MDNich/MIT_Rkt_Aurora_Aero/README.md

# Aurora Aerodynamics Subteam

In this repository, one can find CFD analyses, solidworks files, and other essential infrastructure for the Aerodynamic aspects of the Aurora Project.

(c) MIT Rocket Team 2024
