MDNich/MIT_Rkt_Aurora_Aero/AeroShell_proj/New/ANSYS_wd/Report.htm

ANSYS Logo

Date

2024/10/16 18:46:21

# Contents

1. File Report
Table 1 File Information for FFF
2. Mesh Report
Table 2 Mesh Information for FFF
3. Physics Report
Table 3 Domain Physics for FFF
Table 4 Boundary Physics for FFF
4. User Data

# 1. File Report

Table 1. File Information for FFF

Case | FFF
File Path | \\Mac\Home\Downloads\new_files\dp0\FFF\Fluent\FFF.flprj
File Date | 16 október 2024
File Time | 06:39:04 du.
File Type | CFF
File Version | --

# 2. Mesh Report

Table 2. Mesh Information for FFF

Domain | Nodes | Elements
solide | 101767 | 532187

# 3. Physics Report

Table 3. Domain Physics for FFF

Domain - solide
Type | FLUID
Location | solide

Table 4. Boundary Physics for FFF

Domain | Boundaries
solide | Boundary - backwind
| Type | PRESSURE-OUTLET
| Location | backwind
| Boundary - forwardwind
| Type | VELOCITY-INLET
| Location | forwardwind
| Boundary - sidel
| Type | PRESSURE-OUTLET
| Location | sidel
| Boundary - sider
| Type | PRESSURE-OUTLET
| Location | sider
| Boundary - top
| Type | PRESSURE-OUTLET
| Location | top
| Boundary - wall solide
| Type | WALL
| Location | wall-solide

# 4. User Data
