MDNich/MIT_Rkt_Aurora_Aero/AeroShell_proj/New/ANSYS_wd/Report/index.html

Image file not found

# Ansys Fluent Simulation Report

Analyst | mdn
Date | 10/23/2024 11:12 AM

### Table of Contents

## System Information

Application | Fluent
Settings | 3d, pressure-based, SST k-omega
Version | 24.2.0-10192
Source Revision | 149ed7492d
Build Time | May 13 2024 11:26:32 EST
CPU | UNKNOWN
OS | Windows

## Geometry and Mesh

## Mesh Size

Cells | Faces | Nodes
418755 | 854773 | 78719

## Mesh Quality

Name | Type | Min Orthogonal Quality | Max Aspect Ratio
aeroshell1.0_ansys_thiswillwork | Tet Cell | 0.20434347 | 13.010097

## Orthogonal Quality

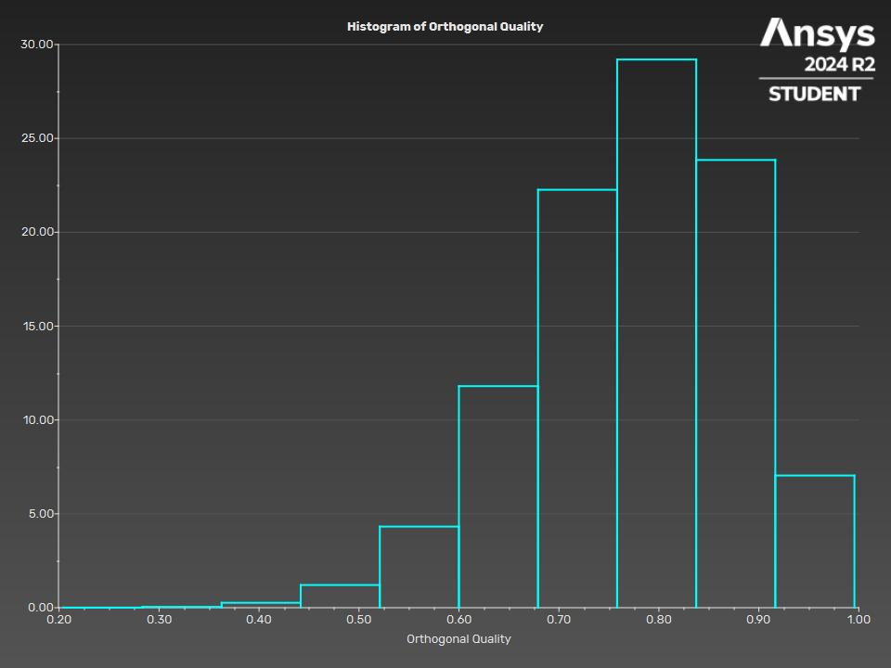
[picture p2: AeroShell_proj/New/ANSYS_wd/Report/media/4b58dbcf-9151-11ef-aaf2-bc9a78563412_image.png]
Image file not found


## Simulation Setup

## Physics

## Models

Model | Settings
Space | 3D
Time | Steady
Viscous | SST k-omega turbulence model

## Material Properties

Fluid
air
Density | 1.225 kg/m^3
Cp (Specific Heat) | 1006.43 J/(kg K)
Thermal Conductivity | 0.0242 W/(m K)
Viscosity | 1.7894e-05 kg/(m s)
Molecular Weight | 28.966 kg/kmol
Solid
aluminum
Density | 2719 kg/m^3
Cp (Specific Heat) | 871 J/(kg K)
Thermal Conductivity | 202.4 W/(m K)

## Cell Zone Conditions

Fluid
aeroshell1.0_ansys_thiswillwork
Material Name | air
Specify source terms? | no
Specify fixed values? | no
Frame Motion? | no
Laminar zone? | no
Porous zone? | no
3D Fan Zone? | no

## Boundary Conditions

Inlet
fata
Velocity Specification Method | Magnitude, Normal to Boundary
Reference Frame | Absolute
Velocity Magnitude [m/s] | 343
Supersonic/Initial Gauge Pressure [Pa] | 0
Turbulence Specification Method | Intensity and Viscosity Ratio
Turbulent Intensity [%] | 2
Turbulent Viscosity Ratio | 10
Outlet
out
Backflow Reference Frame | Absolute
Gauge Pressure [Pa] | 0
Pressure Profile Multiplier | 1
Backflow Direction Specification Method | Normal to Boundary
Turbulence Specification Method | Intensity and Viscosity Ratio
Backflow Turbulent Intensity [%] | 5
Backflow Turbulent Viscosity Ratio | 10
Backflow Pressure Specification | Total Pressure
Build artificial walls to prevent reverse flow? | no
Radial Equilibrium Pressure Distribution | no
Average Pressure Specification? | no
Specify targeted mass flow rate | no
Wall
wall-aeroshell1.0_ansys_thiswillwork
Wall Motion | Stationary Wall
Shear Boundary Condition | No Slip
Wall Surface Roughness | Standard
Wall Roughness Height [m] | 0
Wall Roughness Constant | 0.5

## Reference Values

Area | 1 m^2
Density | 1.225 kg/m^3
Enthalpy | 0 J/kg
Length | 1 m
Pressure | 0 Pa
Temperature | 288.16 K
Velocity | 1 m/s
Viscosity | 1.7894e-05 kg/(m s)
Ratio of Specific Heats | 1.4
Yplus for Heat Tran. Coef. | 300
Reference Zone | aeroshell1.0_ansys_thiswillwork

## Solver Settings

Equations
Flow | True
Turbulence | True
Numerics
Absolute Velocity Formulation | True
Pseudo Time Explicit Relaxation Factors
Density | 1
Body Forces | 1
Turbulent Kinetic Energy | 0.75
Specific Dissipation Rate | 0.75
Turbulent Viscosity | 1
Explicit Momentum | 0.5
Explicit Pressure | 0.5
Pressure-Velocity Coupling
Type | Coupled
Pseudo Time Method (Global Time Step) | True
Discretization Scheme
Pressure | Second Order
Momentum | Second Order Upwind
Turbulent Kinetic Energy | Second Order Upwind
Specific Dissipation Rate | Second Order Upwind
Solution Limits
Minimum Absolute Pressure [Pa] | 1
Maximum Absolute Pressure [Pa] | 5e+10
Minimum Static Temperature [K] | 1
Maximum Static Temperature [K] | 5000
Minimum Turb. Kinetic Energy [m^2/s^2] | 1e-14
Minimum Spec. Dissipation Rate [s^-1] | 1e-20
Maximum Turb. Viscosity Ratio | 100000

## Run Information

Number of Machines | 1
Number of Cores | 4
Case Read | 21.134 seconds
Data Read | 0.727 seconds
Iteration | 78.413 seconds
AMG | 36.519 seconds
Virtual Current Memory | 6.64544 GB
Virtual Peak Memory | 6.68229 GB
Memory Per M Cell | 12.1125

## Solution Status

#### Iterations: 100

| Value | Absolute Criteria | Convergence Status
continuity | 0.09712484 | 0.001 | Not Converged
x-velocity | 0.0003147829 | 0.001 | Converged
y-velocity | 0.0001747776 | 0.001 | Converged
z-velocity | 0.000171075 | 0.001 | Converged
k | 0.01620988 | 0.001 | Not Converged
omega | 0.01409847 | 0.001 | Not Converged

## Plots

- Residuals

## Residuals

## Contours

- shearst
- totp
- dynp
- statp

## shearst

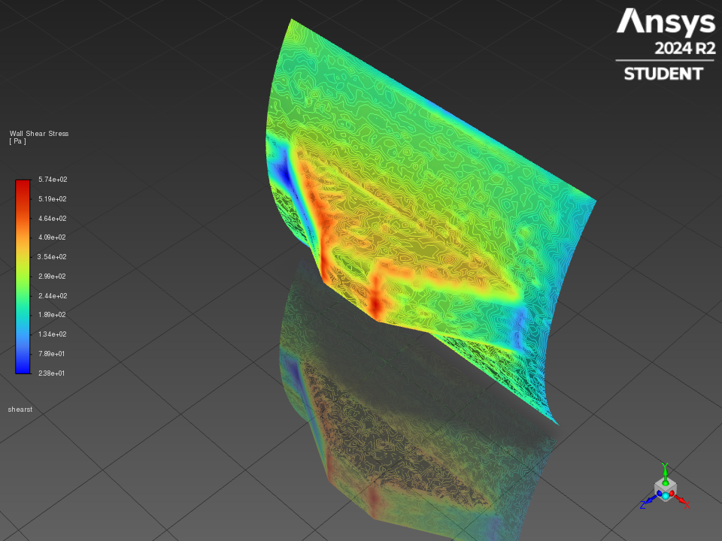
[picture p3: AeroShell_proj/New/ANSYS_wd/Report/media/4d85e509-9151-11ef-a574-bc9a78563412_image.png]
Image file not found


## totp

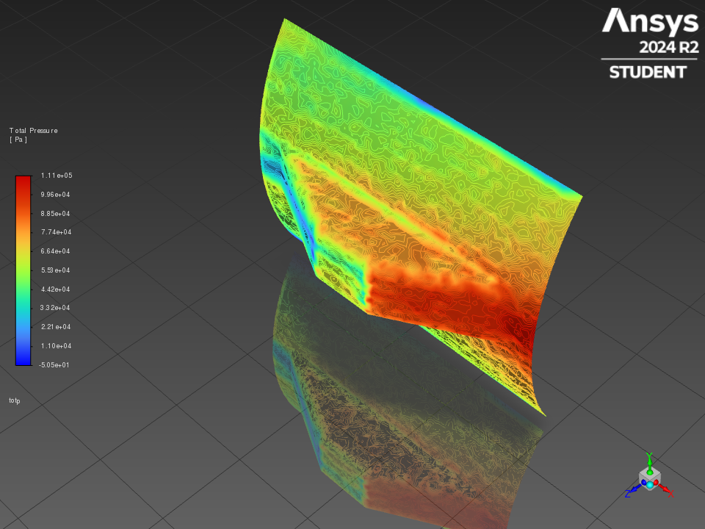
[picture p4: AeroShell_proj/New/ANSYS_wd/Report/media/4f966771-9151-11ef-b3bf-bc9a78563412_image.png]
Image file not found


## dynp

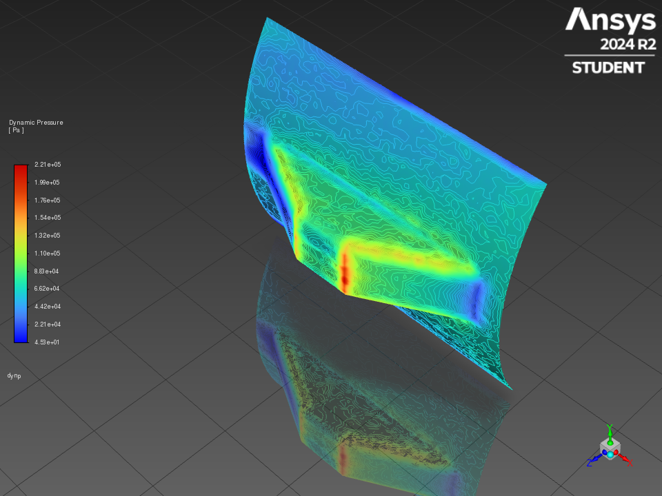
[picture p5: AeroShell_proj/New/ANSYS_wd/Report/media/515c199f-9151-11ef-837b-bc9a78563412_image.png]
Image file not found


## statp

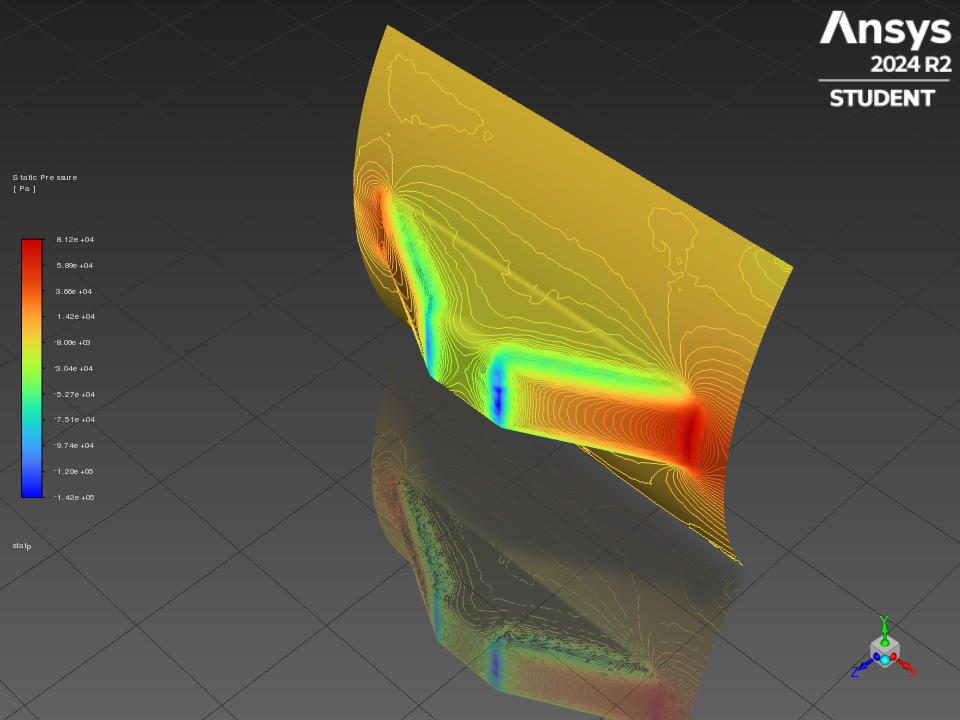
[picture p6: AeroShell_proj/New/ANSYS_wd/Report/media/534bf1fb-9151-11ef-a4d0-bc9a78563412_image.png]
Image file not found


## Pathlines

- pathlines-1

## pathlines-1

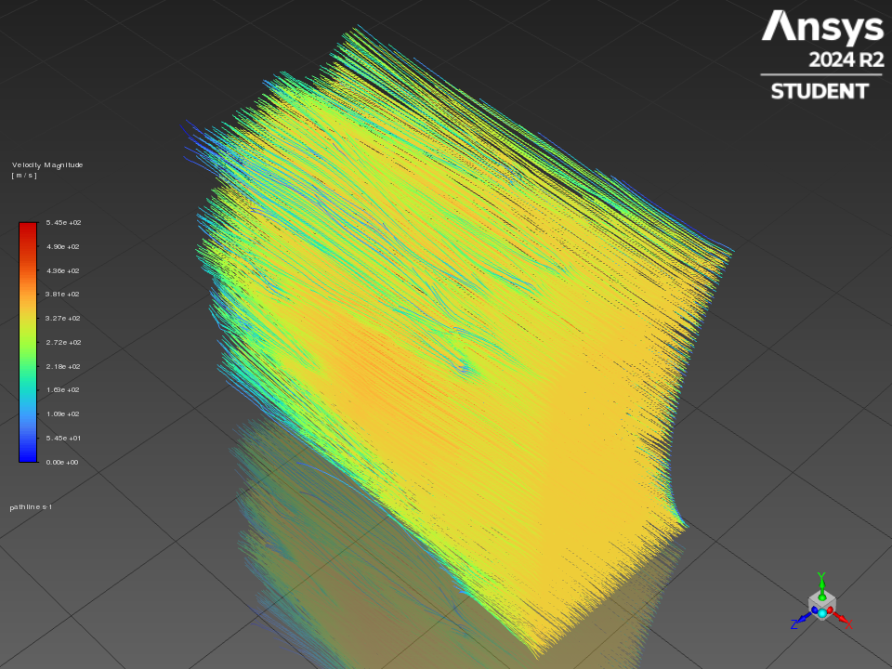
[picture p7: AeroShell_proj/New/ANSYS_wd/Report/media/572a354f-9151-11ef-ac23-bc9a78563412_image.png]
Image file not found


## User Data

- image-1

## image-1

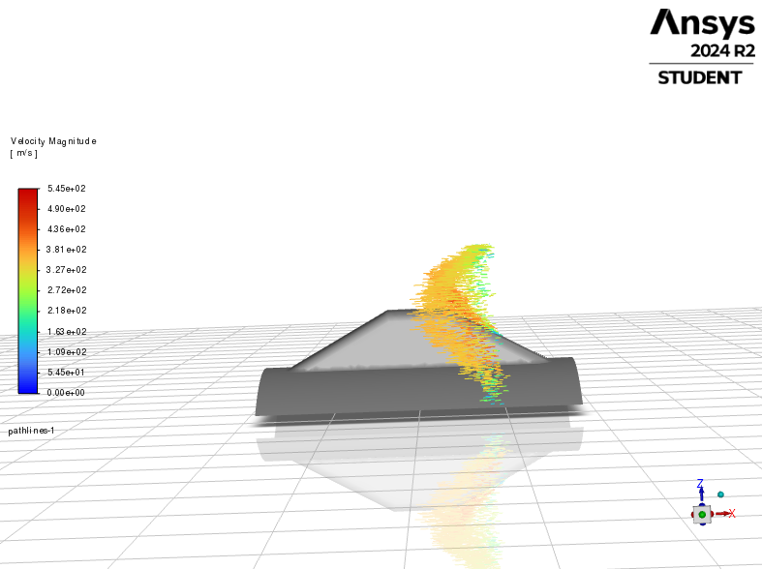
[picture p8: AeroShell_proj/New/ANSYS_wd/Report/media/58689a4f-9151-11ef-af96-bc9a78563412_image.png]
Image file not found
