MDNich/MIT_Rkt_Aurora_Aero/CureChamber/Epoxy Heat Curing Notes.pdf

Epoxy Heat Curing Research:

Options:
1. Heat oven
2. Custom enclosure
3. Heat lamp/blankets
4. Furnace

Potential issues:
- Too big to fit in heat oven/furnace
- Can’t reach required temperature
- Manufacturing of enclosure too difficult
- Space??
- Money

Most viable option atm: Custom enclosure/ heat lamp combo

Sources for reference:
- UV Curing Enclosure Example (https://forum.formlabs.com/t/custom-diy-large-size-uv-curing-enclosure-wip/7543) - Basic design of enclosure is transferable to our custom enclosure; heat lamp type will need to be modified to a much more powerful model for our use and inner layers may require more insulation to in turn be equipped to handle higher temperatures
- Cure Box For Composite Builds (https://www.youtube.com/watch?v=HxJONzVlXNQ) - Only currently utilizes on lamp, proportions need to be scaled up for our use and to include heat lamps on four faces to perform consistent curing

Concept Sketch:

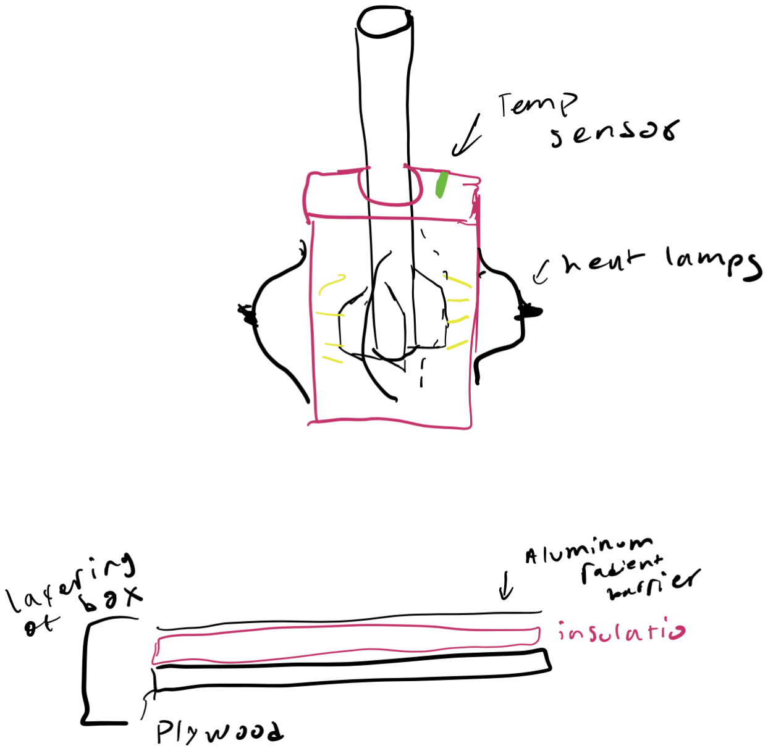
[picture p10: figure]

Type of epoxy: System 40600 Spec Sheet (https://s3.amazonaws.com/cdn.fibreglast.com/downloads/04160.pdf)

Curing Temperatures and Times:

Ideal Time and Temp:

### To Build Oven

Parts Needed:
1. Insulation board (https://www.lowes.com/pd/Insulfoam-Common-0-5-in-x-4-ft-x-8-ft-Actual-0-5-in-x-4-ft-x-8-ft-1-R-1-9-Faced-Polystyrene-Garage-Door-Foam-Board-Insulation/3033278)
a. 2 layers?
2. Insulation Aluminum Tape (https://www.uline.com/Product/Detail/S-18880/3M-Foil-Tape/3M-3311-Aluminum-Foil-Tape-2-x-50-yds?id=S-18880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)
3. Regular insulation (https://www.homedepot.com/p/ROCKWOOL-Safe-n-Sound-3-in-x-15-1-4-in-x-47-in-Soundproofing-and-Fire-Resistant-Stone-Wool-Insulation-Batt-59-7-sq-ft-RXSS31525/20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)
4. Plywood (https://www.homedepot.com/p/Blue-Ribbon-Oriented-Strand-Board-Common-19-32-in-x-4-ft-x-8-ft-Actual-0-578-in-x-47-75-in-x-95-75-in-691459/205821485)
5. 2x4s (https://www.homedepot.com/p/2-in-x-4-in-x-96-in-2-Premium-Grade-KD-HT-Stud-058449/312528776)
6. Silver heat reflective foil (https://www.homedepot.com/p/Pro-Space-48-in-x-10-ft-Radiant-Barrier-Bubble-Aluminum-Foil-Reflective-Insulation-RBQP54810/327522328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)
7. Fans for circulation (https://www.mcmaster.com/products/fans/fans-1~/high-temperature-equipment-cooling-fans/)
8. PID controller? (https://www.amazon.com/CGELE-Temperature-Controller-180-240V-Thermocouple/dp/B08ZYHFBYW?hvadid=697547374301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)
9. Heat Lamp Controller (https://www.amazon.com/REPTIZOO-Thermostat-Temperature-Controller-Function/dp/B0BGS517FT?th=1&psc=1) x2
a. Bulb (https://www.amazon.com/SPOTTEDSALAMADER-Infrared-Basking-Reptile-Heating/dp/B0DCB7GGYH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)
b. Mounts (https://www.amazon.com/2RZ-Reptile-Ceramic-Bracket-Included/dp/B07YWPPLMH?sp_csd=d2lkZ2V0TmFtZT1zcF9hdGY) x2
Cost of Parts (assuming RT does not have anything)
Part | Amount | Cost per Unit | Total Cost
PID Controller (https://www.amazon.com/Temperature-Controller-Jaybva-Programmable-Thermocouple/dp/B07XKRQ1SY) | 1 | 37 | 37
Heat Lamp (https://www.homedepot.com/p/Feit-Electric-250-Watt-BR40-Red-Reflector-E26-Heat-Lamp-Dimmable-120-Volt-Incandescent-Light-Bulb-250R40-10/304312180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) | 2 | 6 | 12
Lamp holder (https://www.amazon.com/AdiyZ-Pendant-Light-Cord-Chandelier/dp/B0C69JPY5S) | 2 | 17 | 34
Aluminum Foil Tape (https://www.amazon.com/Aluminum-Ductwork-Temperature-Insulation-Adhesive/dp/B0B6NDFXPN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) | 1 | 6 | 6
Insulation (https://www.homedepot.com/p/Owens-Corning-R13-Thermafiber-Fire-and-Sound-Guard-Plus-Mineral-Wool-Insulation-Batt-15-in-x-47-in-1196588/319880476) | 1 | 50 | 50

Aluminum Foil Wrap (https://www.homedepot.com/p/Pro-Space-48-in-x-10-ft-Radiant-Barrier-Bubble-Aluminum-Foil-Reflective-Insulation-RBQP54810/327522328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) | 1 | 24 | 24
Carbon Steel Plate (https://www.onlinemetals.com/en/buy/carbon-steel/18-ga-0-048-carbon-steel-sheet-a1008-cold-roll/pid/14695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) | 6 | 18.47 | 111
Total | | | 274

Insulation Board Specs: (https://pdf.lowes.com/productdocuments/a7ee0c58-6976-4418-82a2-40a9ee2816f8/62997833.pdf)

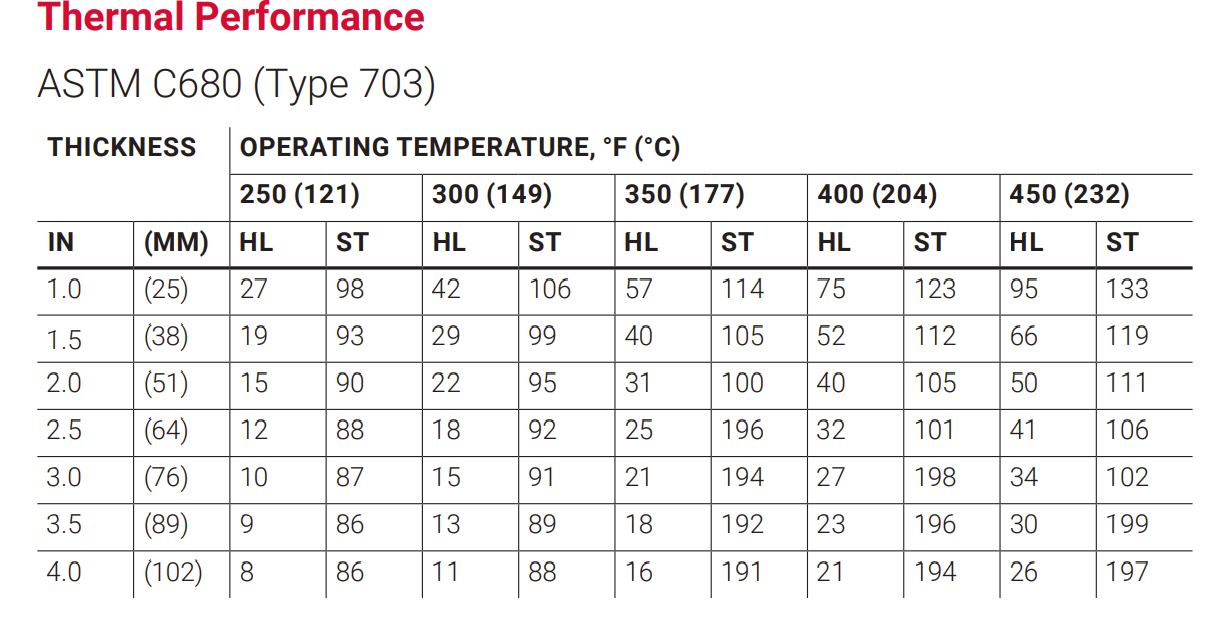
[picture p11: figure]

Insulation Option (https://www.homedepot.com/p/Owens-Corning-15-in-x-47-in-R21-Thermafiber-Fire-and-Sound-Guard-Plus-Mineral-Wool-Insulation-Batt-1196589/319880604)
