MDNich/MIT_Rkt_Aurora_Aero/FEA_docs/rosette.pdf

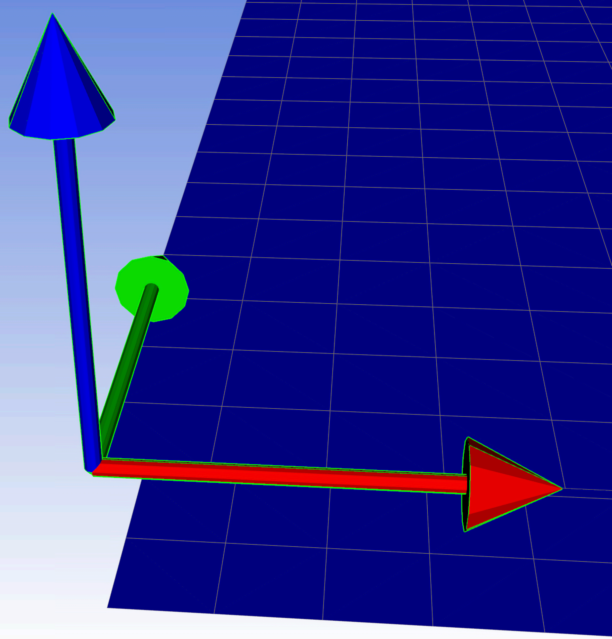
[picture p20: page 1]
