MDNich/MIT_Rkt_Aurora_Aero/FEA_docs/dessin1.pdf

11.714

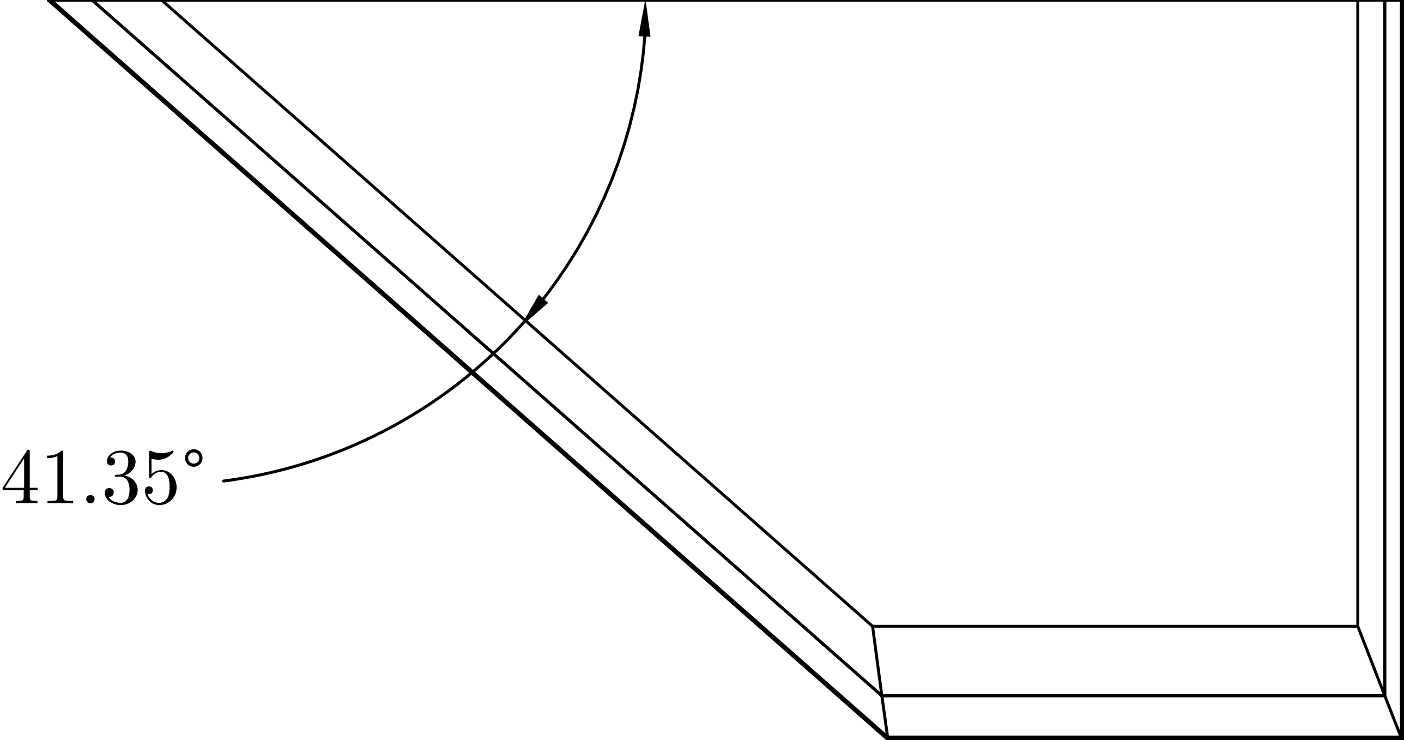
[picture p21: figure]

6

3

8

6

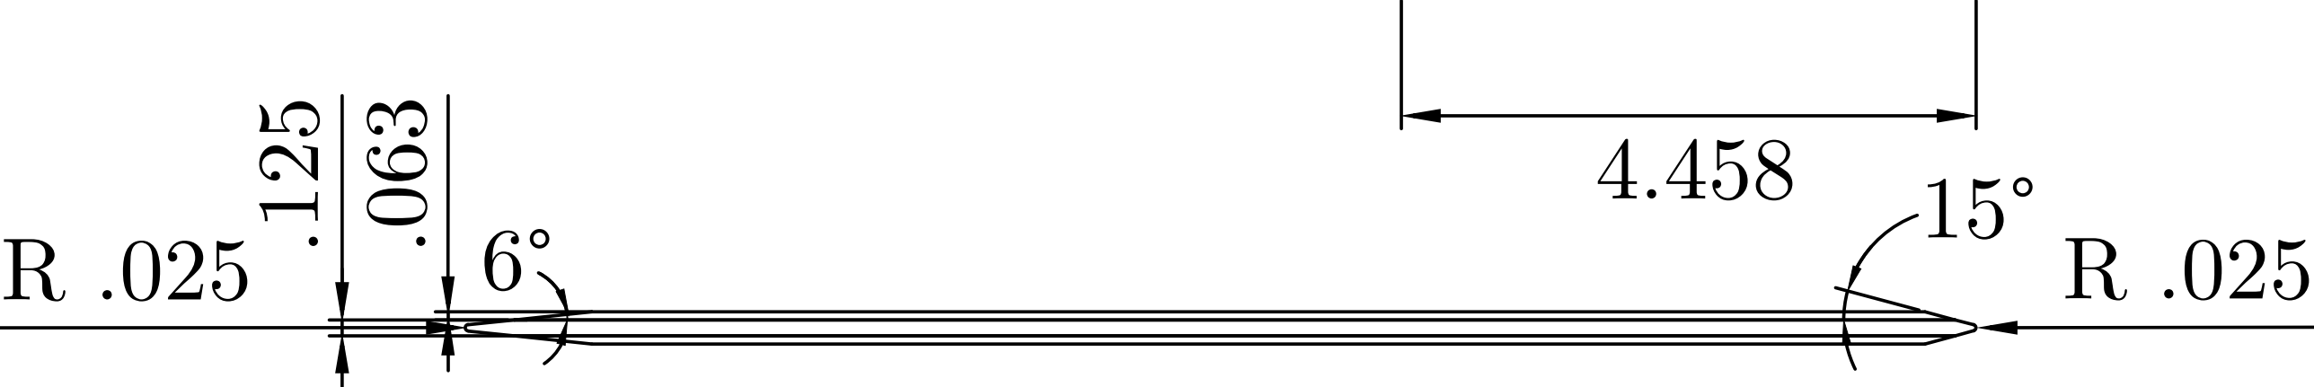
[picture p22: figure]
