MDNich/MIT_Rkt_Aurora_Aero/FEA_docs/rtlogo.pdf

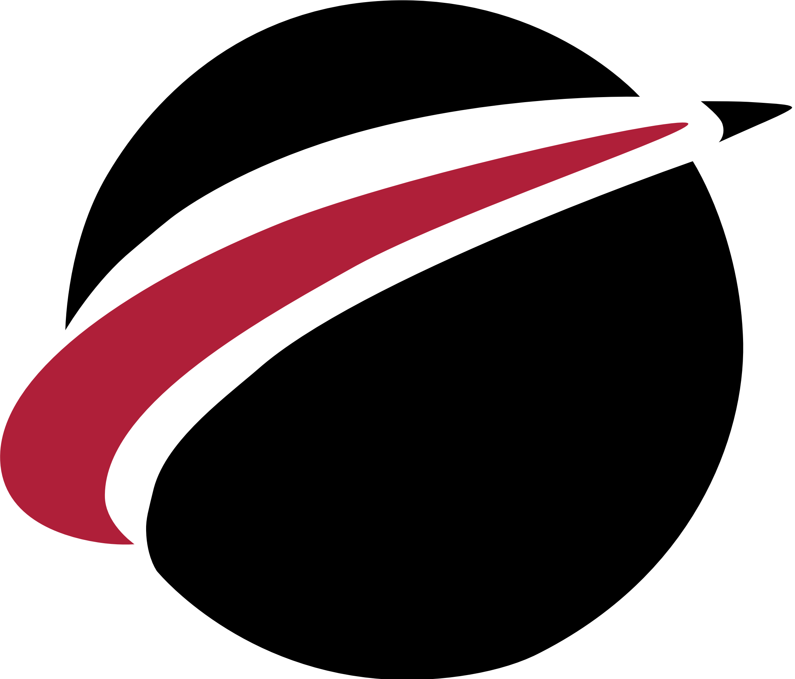
[picture p23: figure]

MIT
TEAM

ROCKET
