MDNich/MIT_Rkt_Aurora_Aero/AeroShell_proj/Analysis/img/sldwrks/new_Mach1_res.png

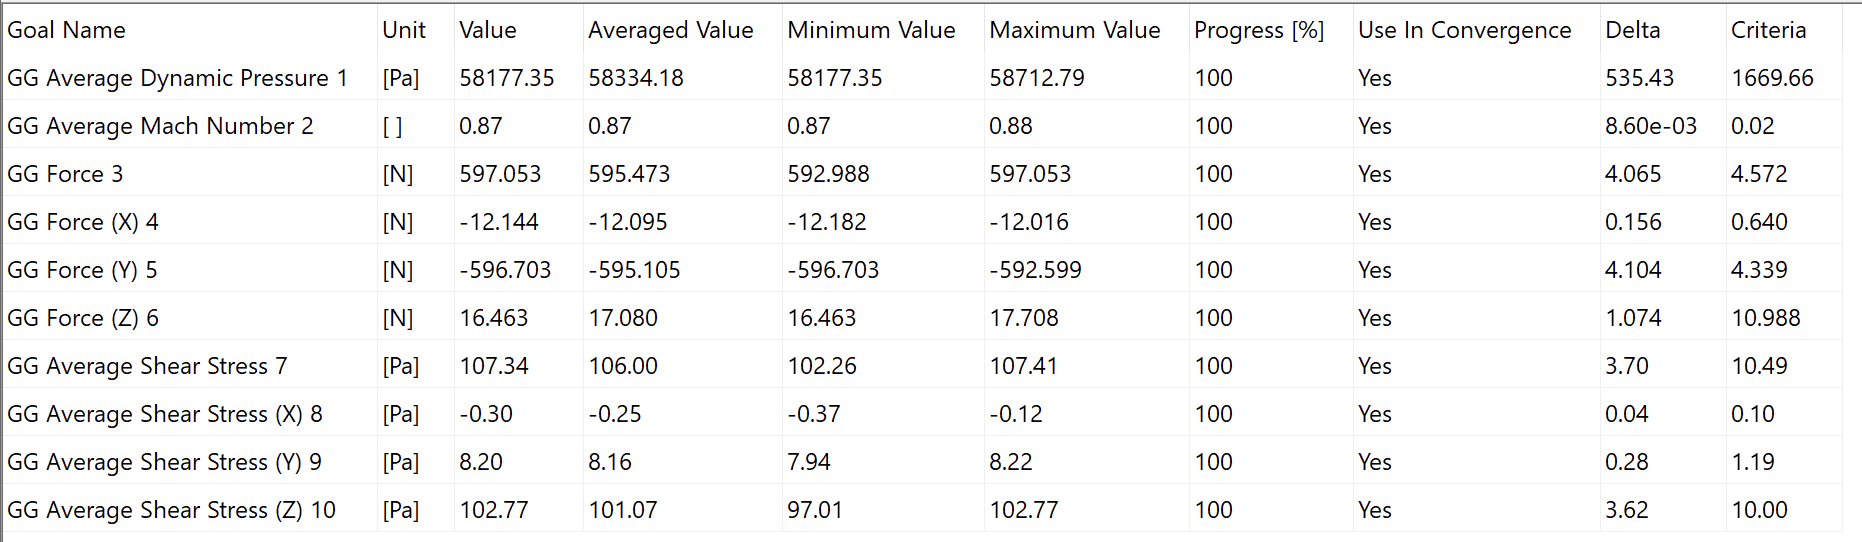
AeroShell_proj/Analysis/img/sldwrks/new_Mach1_res.png
