MDNich/MIT_Rkt_Aurora_Aero/AeroShell_proj/Analysis/src/ansys/new/staticPressure.png

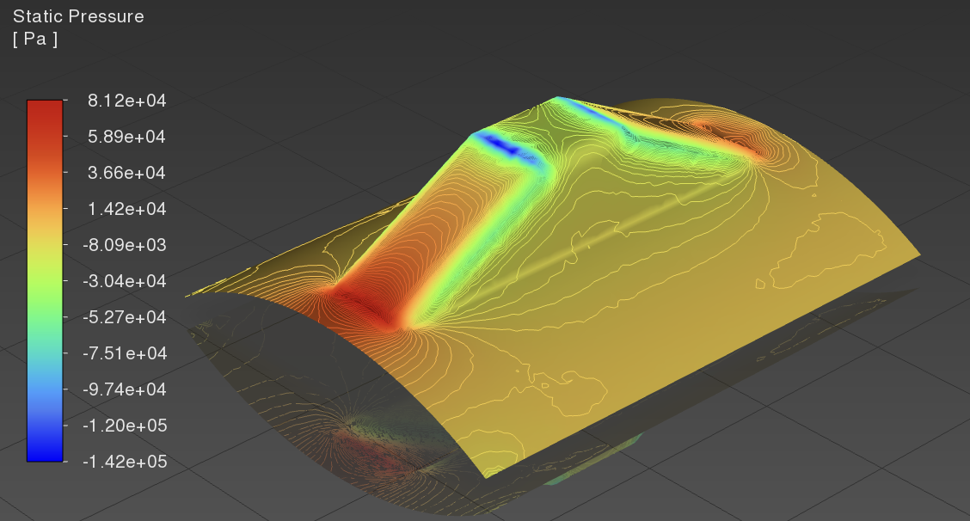
AeroShell_proj/Analysis/src/ansys/new/staticPressure.png
