MDNich/MIT_Rkt_Aurora_Aero/AeroShell_proj/Analysis/src/ansys/new/totalPressure.png

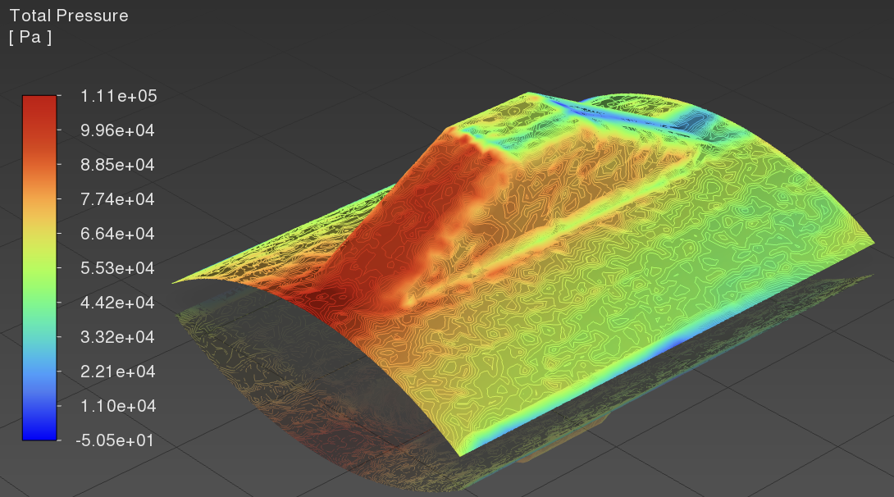
AeroShell_proj/Analysis/src/ansys/new/totalPressure.png
