MDNich/MIT_Rkt_Aurora_Aero/AeroShell_proj/New/ANSYS_wd/Report/media/nexus_front_page.png

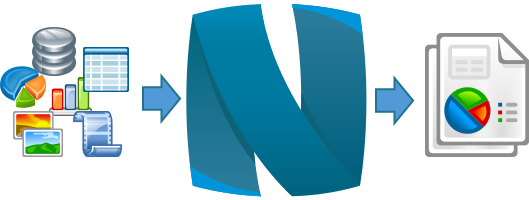
AeroShell_proj/New/ANSYS_wd/Report/media/nexus_front_page.png
