MDNich/MIT_Rkt_Aurora_Aero/AeroShell_proj/New/preview_new.png

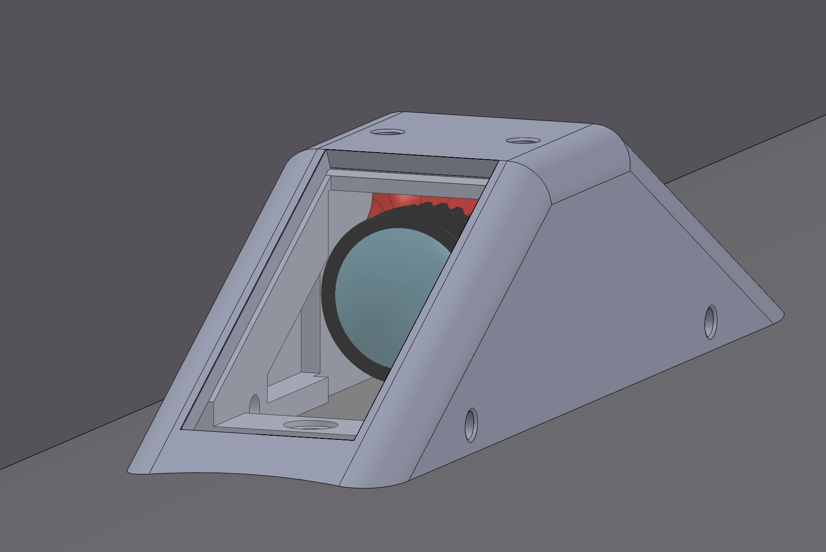
AeroShell_proj/New/preview_new.png
