MDNich/MIT_Rkt_Aurora_Aero/CureChamber/cureChamberCircuitry.png

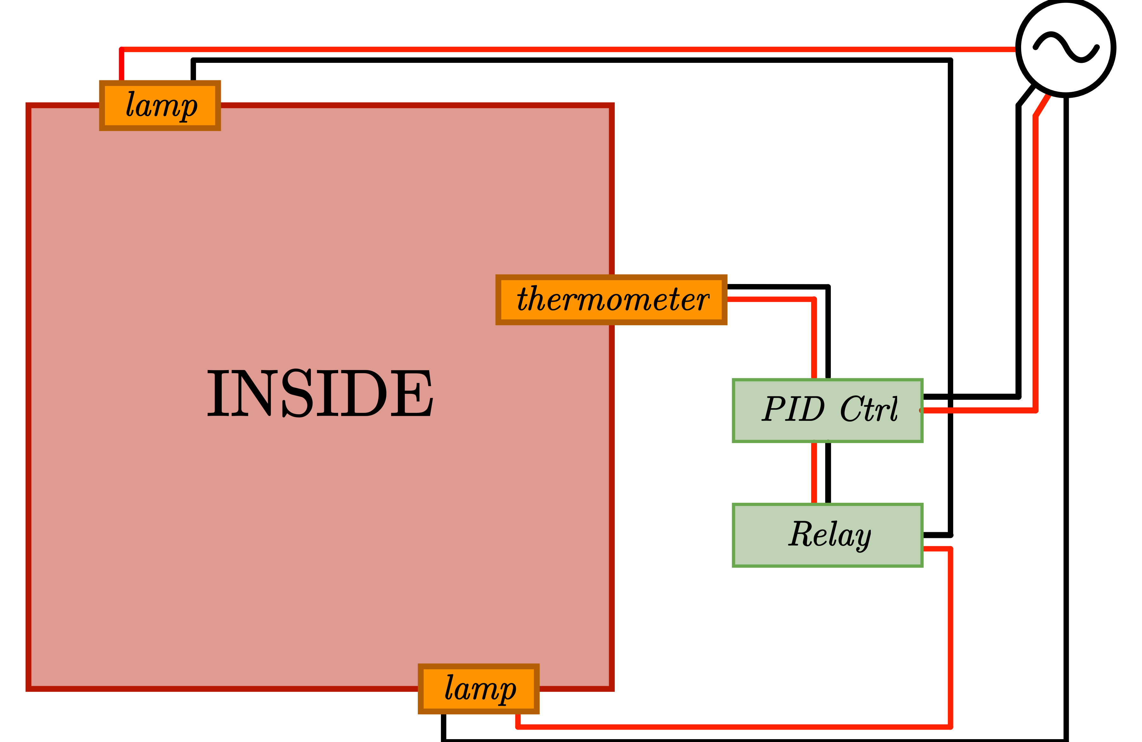
CureChamber/cureChamberCircuitry.png
