MDNich/MIT_Rkt_Aurora_Aero/CureChamber/plug.png

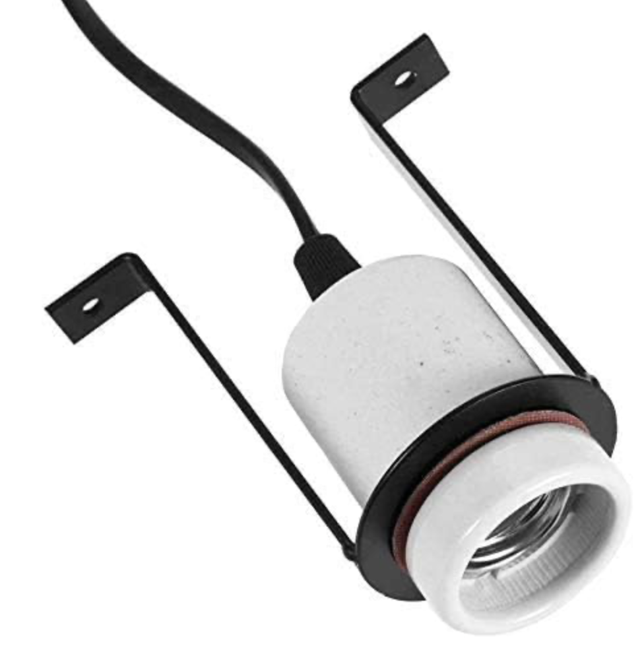
CureChamber/plug.png
