MDNich/MIT_Rkt_Aurora_Aero/CureChamber/tree3a.png

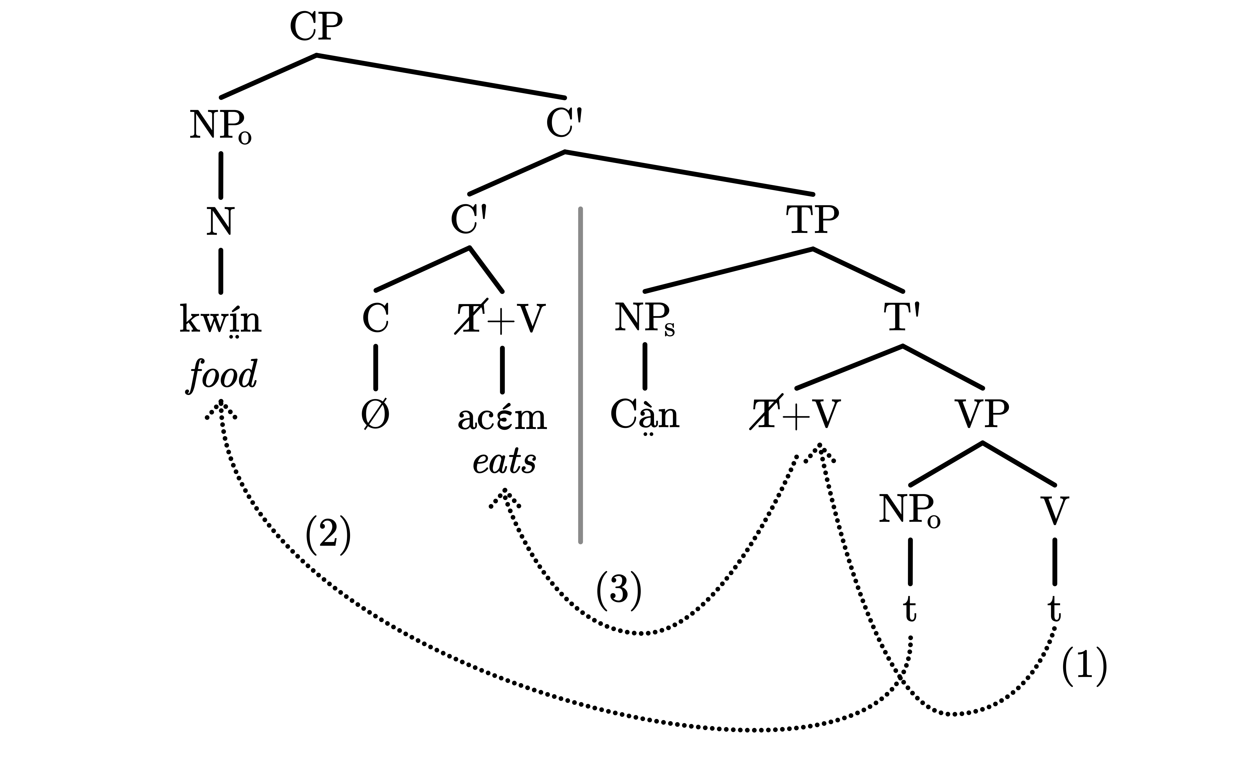
CureChamber/tree3a.png
