MDNich/MIT_Rkt_Aurora_Aero/docs/finStruct.png

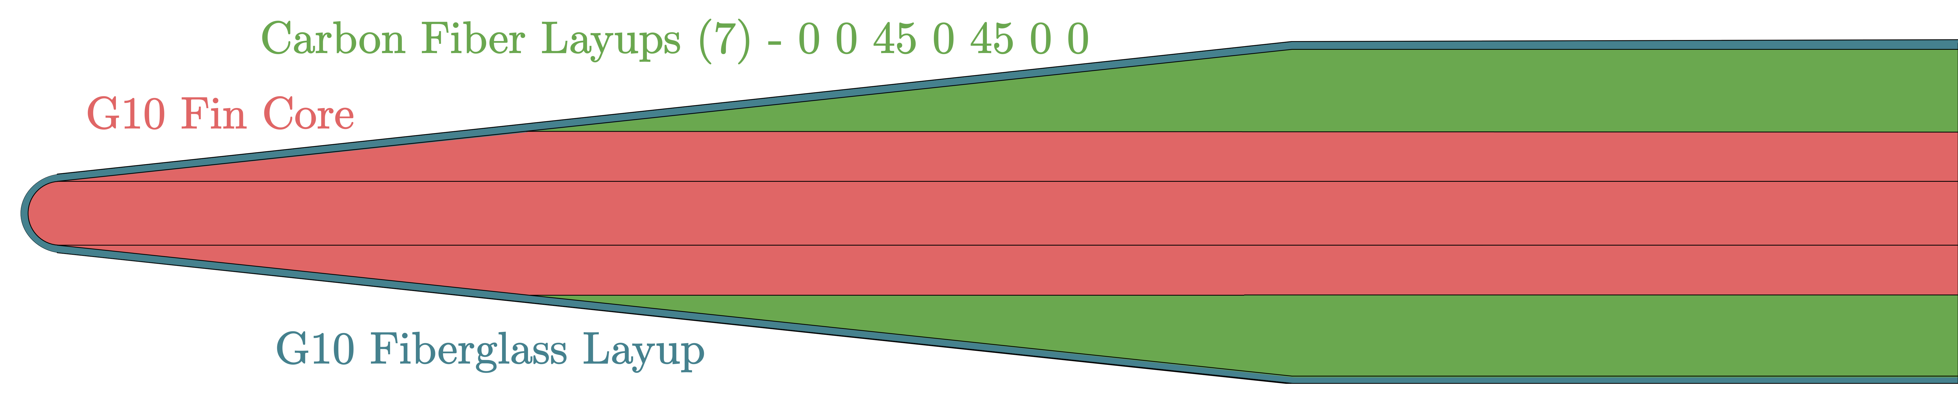
docs/finStruct.png
