MDNich/MIT_Rkt_Aurora_Aero/epoxySIM/fig.png

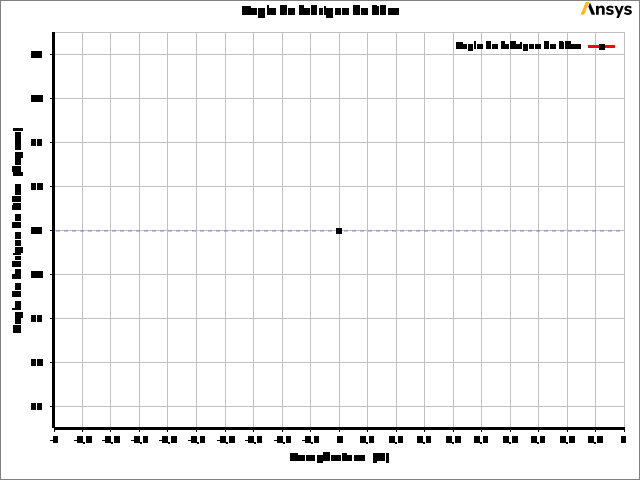
epoxySIM/fig.png
