MDNich/MIT_Rkt_Aurora_Aero/jig/render.jpg

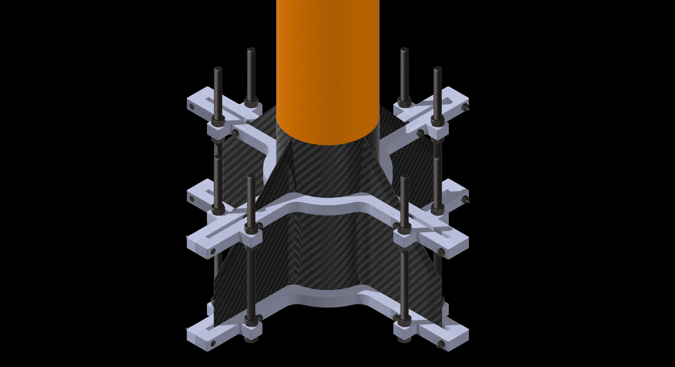
jig/render.jpg
