MDNich/MIT_Rkt_Aurora_Aero/pic/booster.png

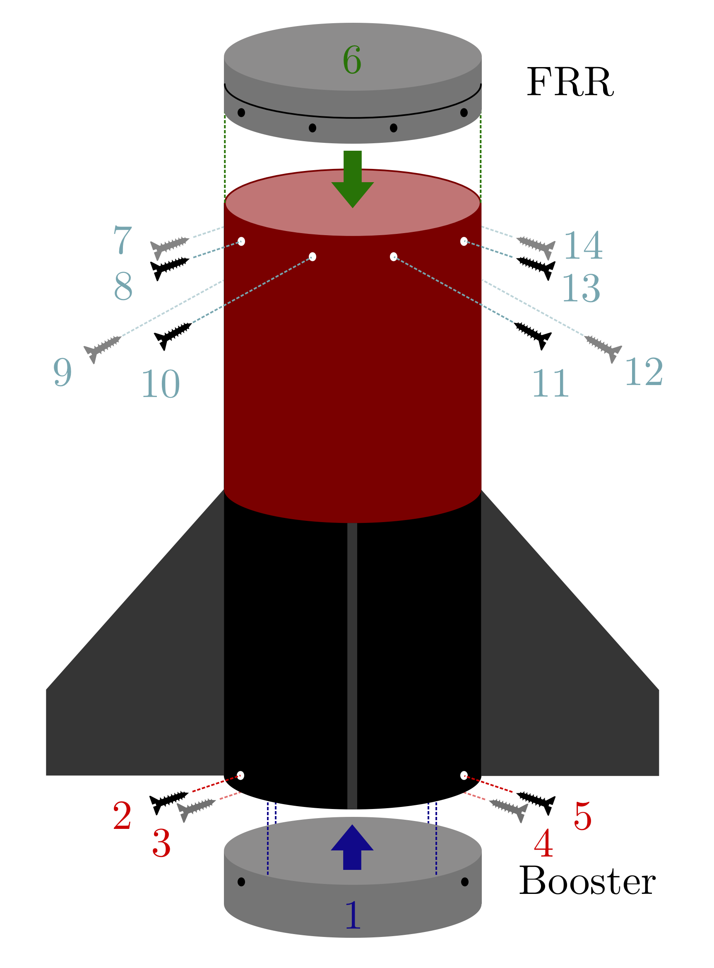
pic/booster.png
