MDNich/MIT_Rkt_Aurora_Aero/CureChamber/lamp.SLDASM

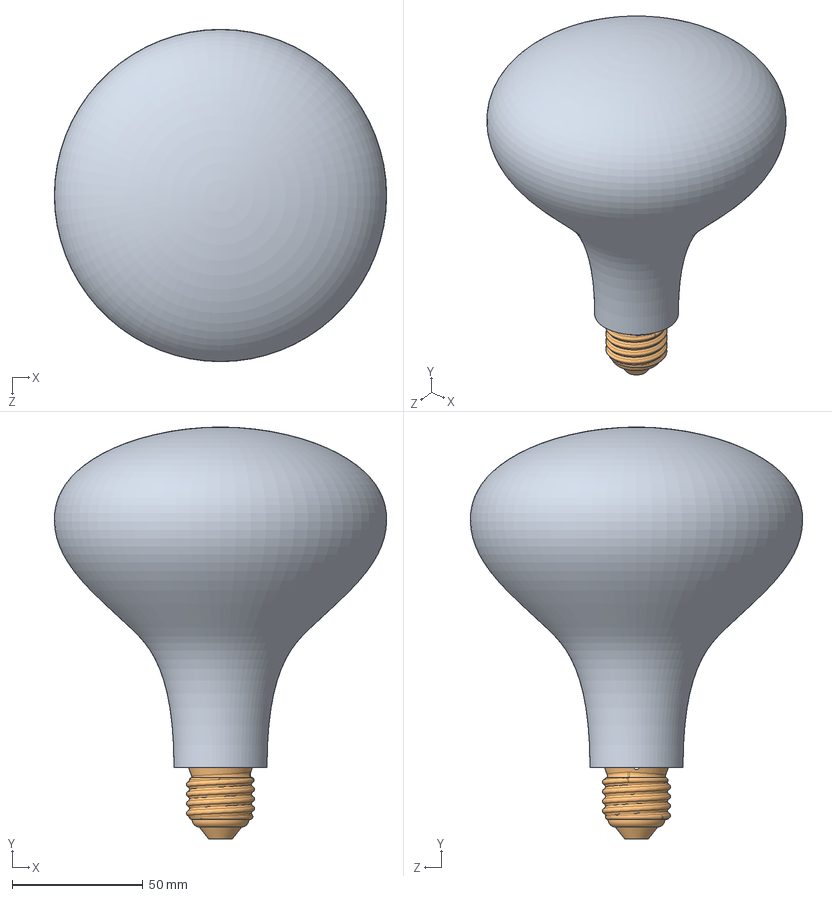
[picture p44: CAD file, 2024-11-23]
CureChamber/lamp.SLDASM
127.0 x 157.4 x 127.0 mm
soquete
bulb
