MDNich/MIT_Rkt_Aurora_Aero/tiptotip/full.SLDPRT

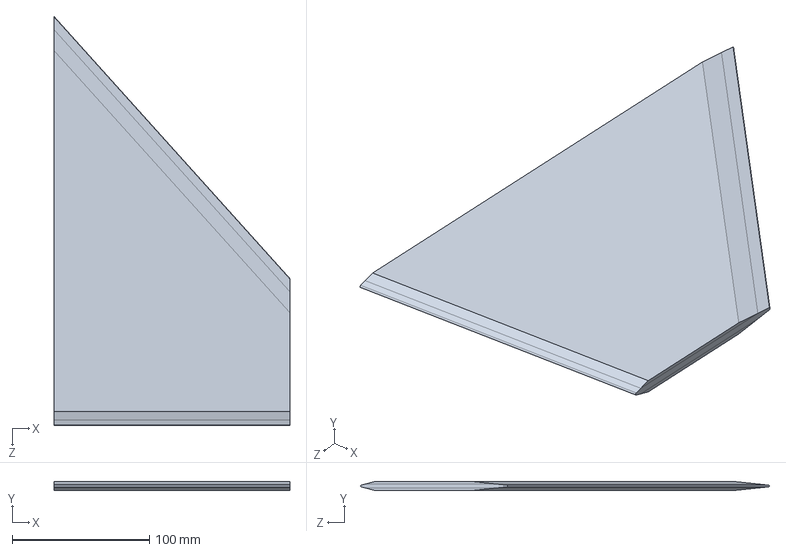
[picture p45: CAD file, 2025-03-09]
tiptotip/full.SLDPRT
171.5 x 6.38 x 297.5 mm
