MDNich/MIT_Rkt_Aurora_Aero/jig/finCanOutsideJust_main.SLDPRT

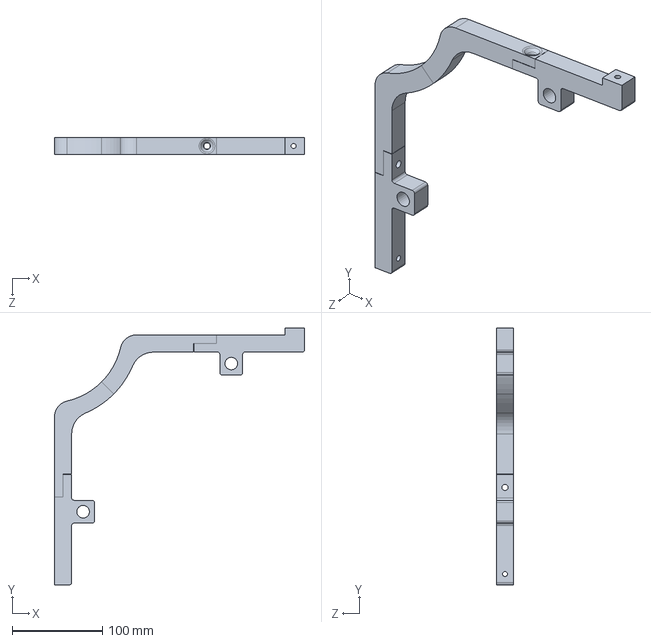
[picture p46: CAD file, 2025-01-24]
jig/finCanOutsideJust_main.SLDPRT
277.5 x 285.1 x 19.1 mm
