MDNich/MIT_Rkt_Aurora_Aero/AeroShell_proj/New/ANSYS_wd/Assembly1.0.SLDASM

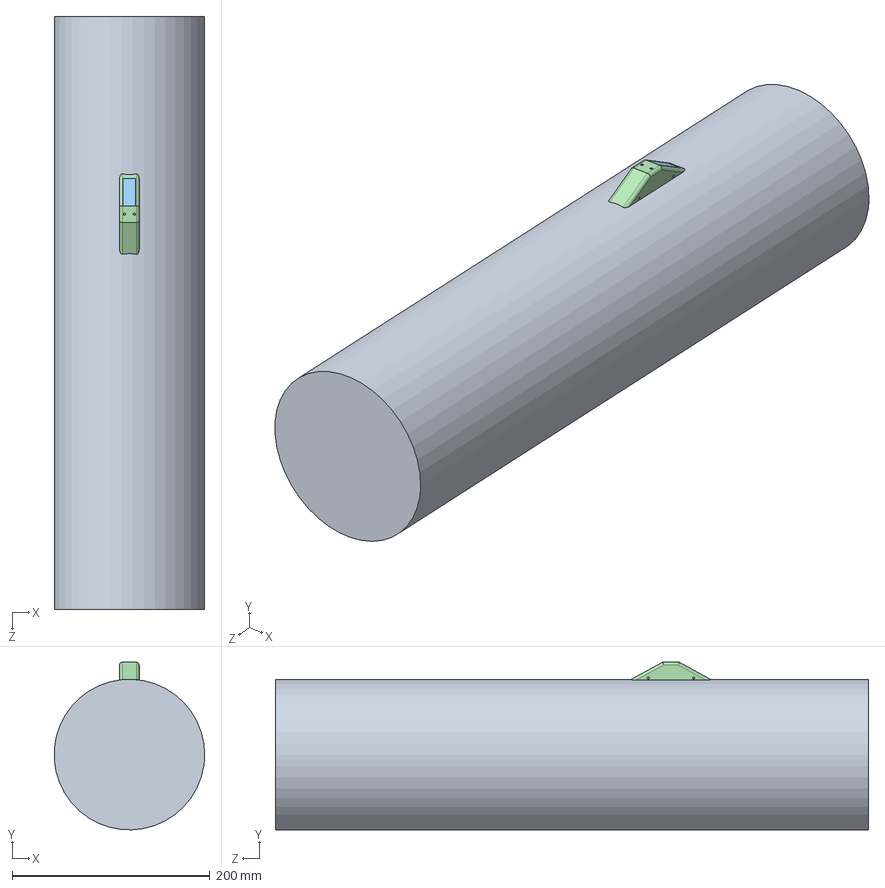
[picture p47: CAD file, 2024-10-12]
AeroShell_proj/New/ANSYS_wd/Assembly1.0.SLDASM
152.2 x 169.7 x 600.0 mm
Aeroshell1.0
GlassPanel
Skeleton1.0
CylindreDummy
