MDNich/MIT_Rkt_Aurora_Aero/FinCan/AssemblageEnPartie.STEP

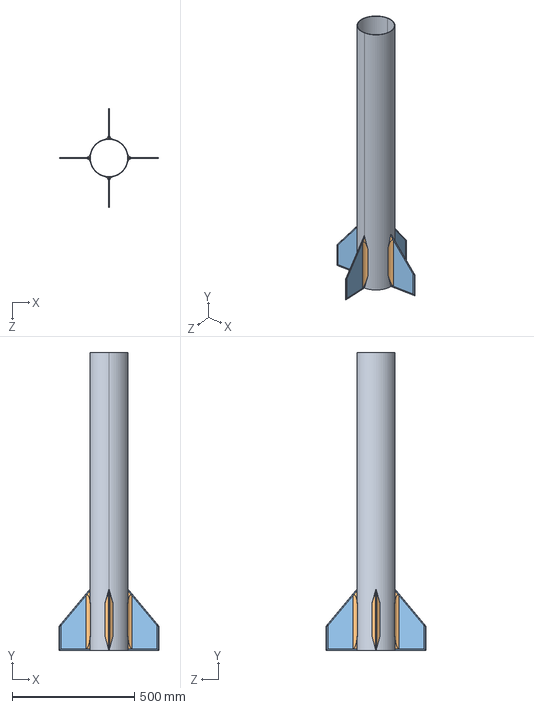
[picture p48: CAD file, 2024-10-27]
FinCan/AssemblageEnPartie.STEP
407.5 x 1219.2 x 407.5 mm
