MDNich/MIT_Rkt_Aurora_Aero/FinCan/Assemblage1.SLDASM

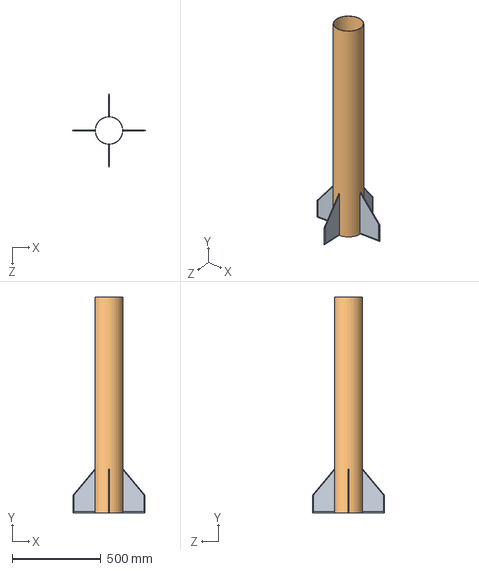
[picture p49: CAD file, 2024-10-26]
FinCan/Assemblage1.SLDASM
407.5 x 1219.2 x 407.5 mm
AirFrame
fin x 4
