MDNich/MIT_Rkt_Aurora_Aero/aeroshell/bstr_aeroshell_aurora_1.5_skeleton_27.04.2025.STEP

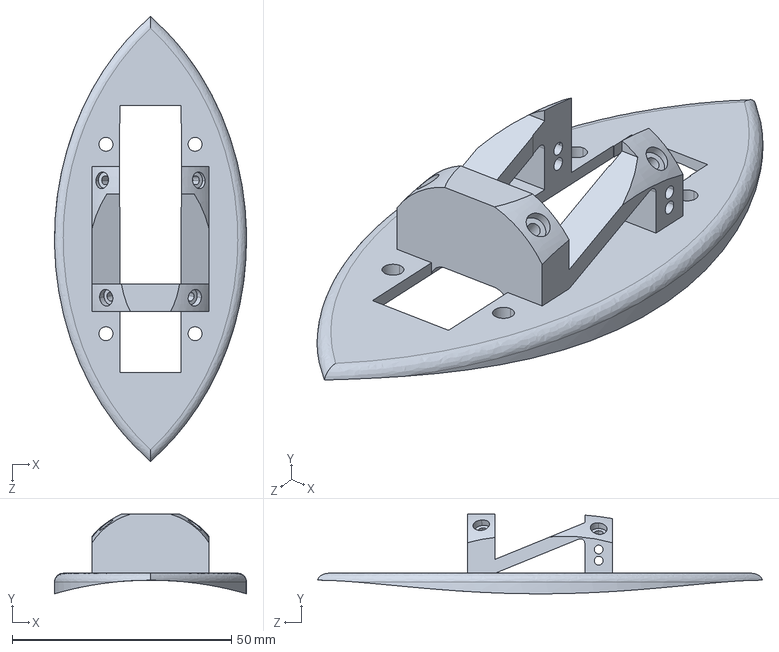
[picture p50: CAD file, 2025-05-06]
aeroshell/bstr_aeroshell_aurora_1.5_skeleton_27.04.2025.STEP
43.8 x 18.2 x 101.5 mm
