MDNich/MIT_Rkt_Aurora_Aero/AeroShell_proj/New/Aeroshell1.0_ANSYS.STEP

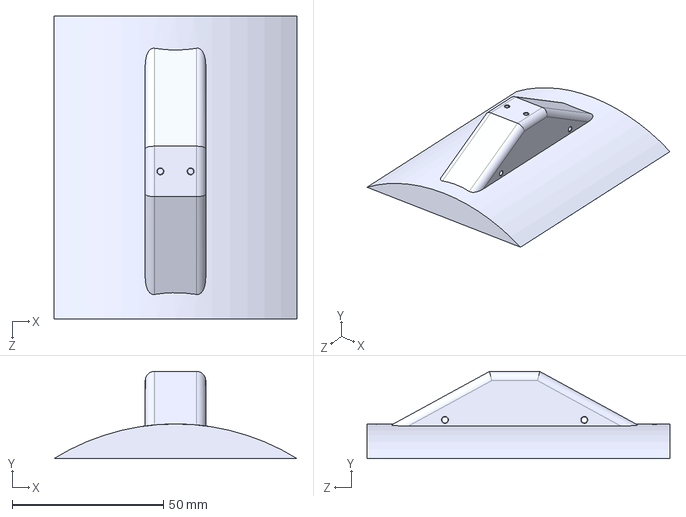
[picture p51: CAD file, 2024-10-19]
AeroShell_proj/New/Aeroshell1.0_ANSYS.STEP
80.2 x 28.8 x 100.0 mm
