MDNich/MIT_Rkt_Aurora_Aero/CureChamber/chamber.SLDPRT

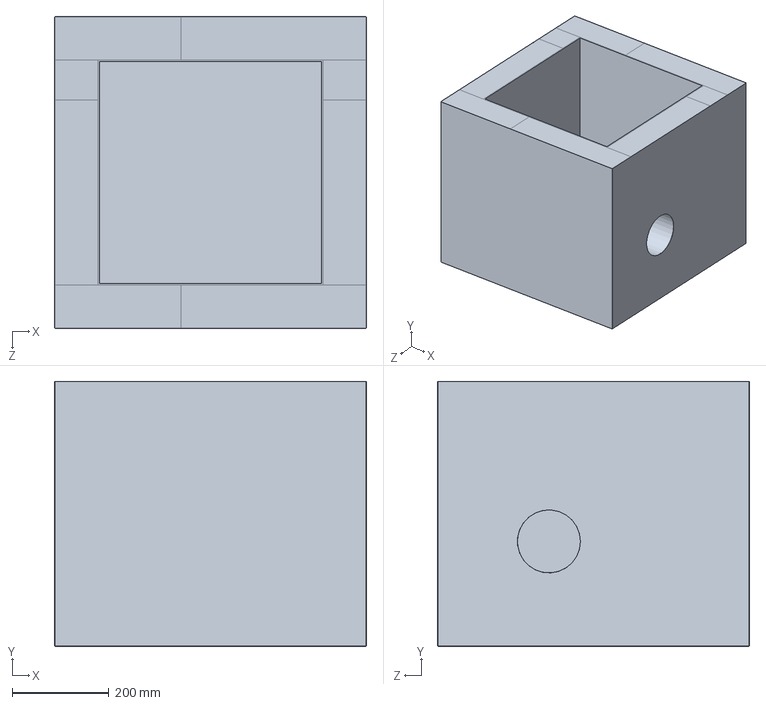
[picture p53: CAD file, 2024-11-23]
CureChamber/chamber.SLDPRT
643.5 x 547.3 x 643.5 mm
