MDNich/MIT_Rkt_Aurora_Aero/epoxySIM/mesh.stl

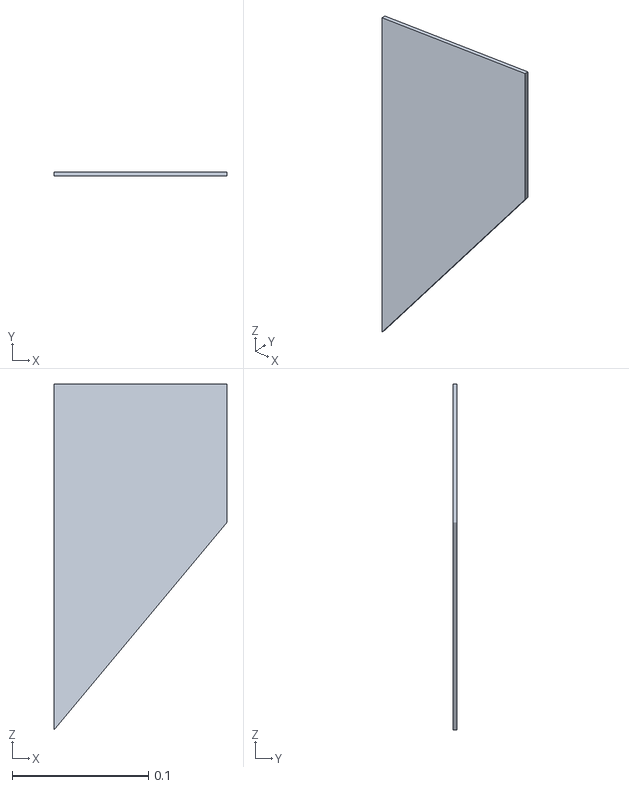
[picture p54: CAD file, 2024-11-23]
epoxySIM/mesh.stl
0.127 x 0.00317 x 0.254
