MDNich/MIT_Rkt_Aurora_Aero/FinCan/finCan_new_2025.01.17.13h50.SLDPRT

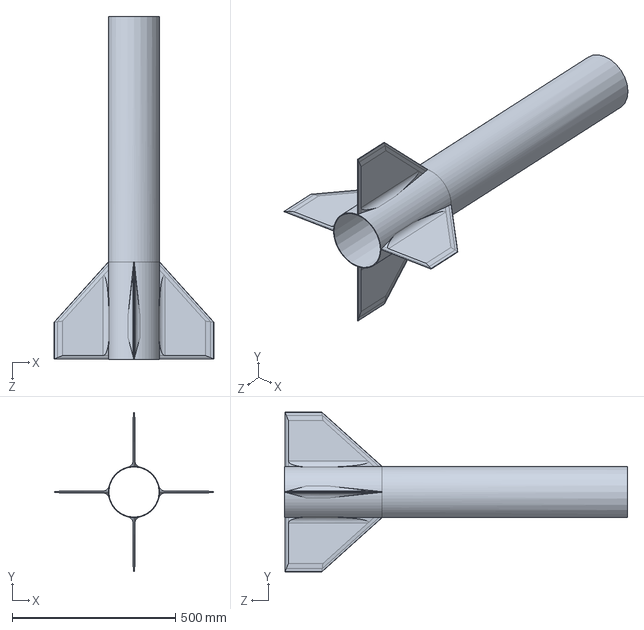
[picture p55: CAD file, 2025-01-17]
FinCan/finCan_new_2025.01.17.13h50.SLDPRT
489.2 x 489.2 x 1052.0 mm
