MDNich/MIT_Rkt_Aurora_Aero/holes/aura-prop-case-v1_1.SLDPRT

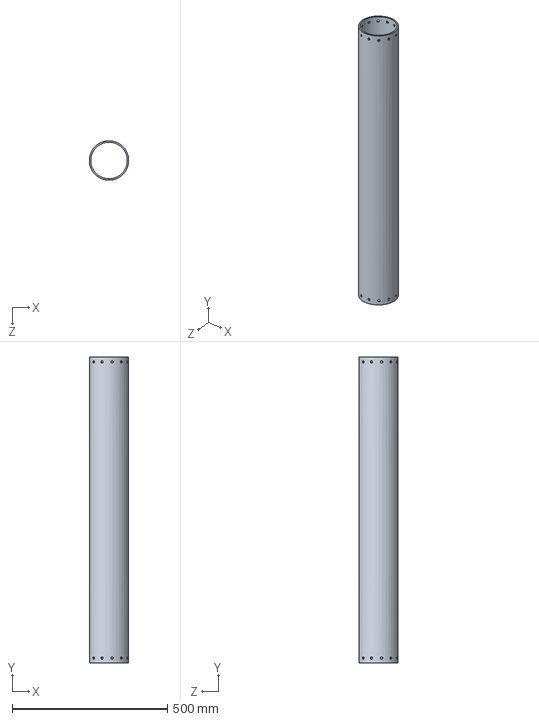
[picture p56: CAD file, 2025-02-01]
holes/aura-prop-case-v1_1.SLDPRT
127.0 x 984.2 x 127.0 mm
