MDNich/MIT_Rkt_Aurora_Aero/jig/aura-aerod-finCan-v1.9_jig_insert.SLDPRT

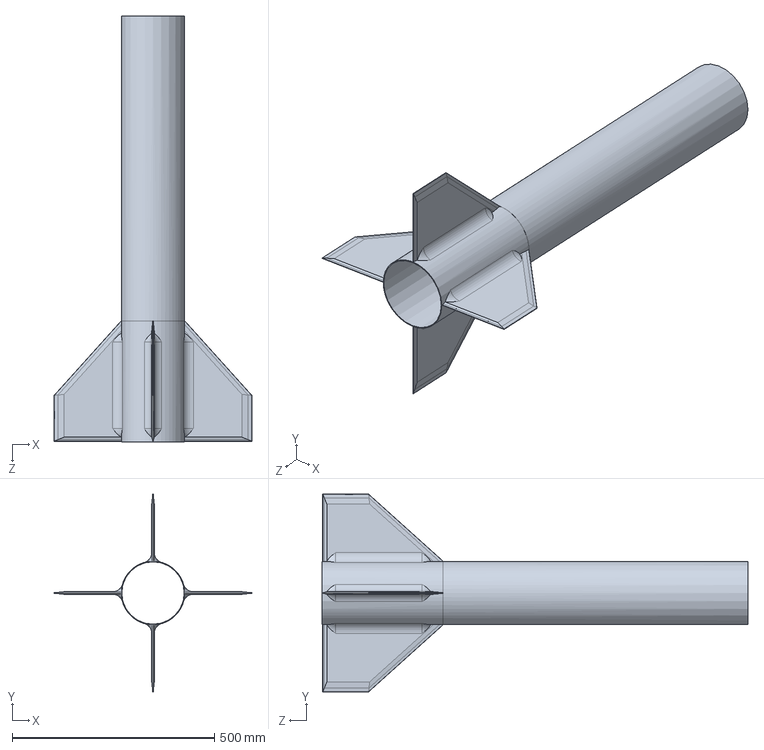
[picture p57: CAD file, 2025-03-09]
jig/aura-aerod-finCan-v1.9_jig_insert.SLDPRT
488.7 x 488.7 x 1052.0 mm
