MDNich/MIT_Rkt_Aurora_Aero/proc/bstr_aeroshell_aurora_1.5_skeleton_27.04.2025.step

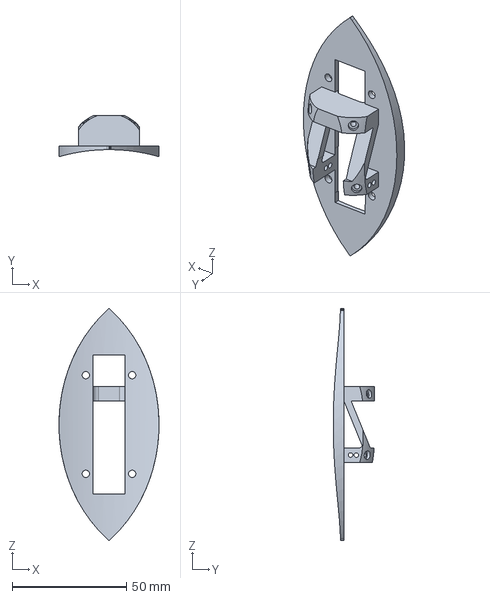
[picture p58: CAD file, 2025-05-06]
proc/bstr_aeroshell_aurora_1.5_skeleton_27.04.2025.step
43.8 x 18.2 x 101.6 mm
