MDNich/MIT_Rkt_Aurora_Aero/sanding/woodSanding1.SLDPRT

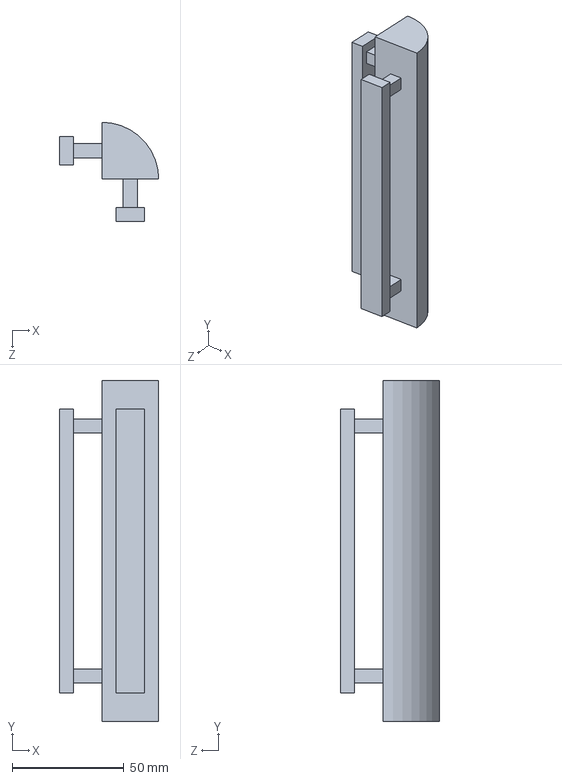
[picture p59: CAD file, 2025-02-03]
sanding/woodSanding1.SLDPRT
44.5 x 152.4 x 44.5 mm
