MDNich/MIT_Rkt_Aurora_Aero/AeroShell_proj/New/ANSYS_wd/mesh.stl

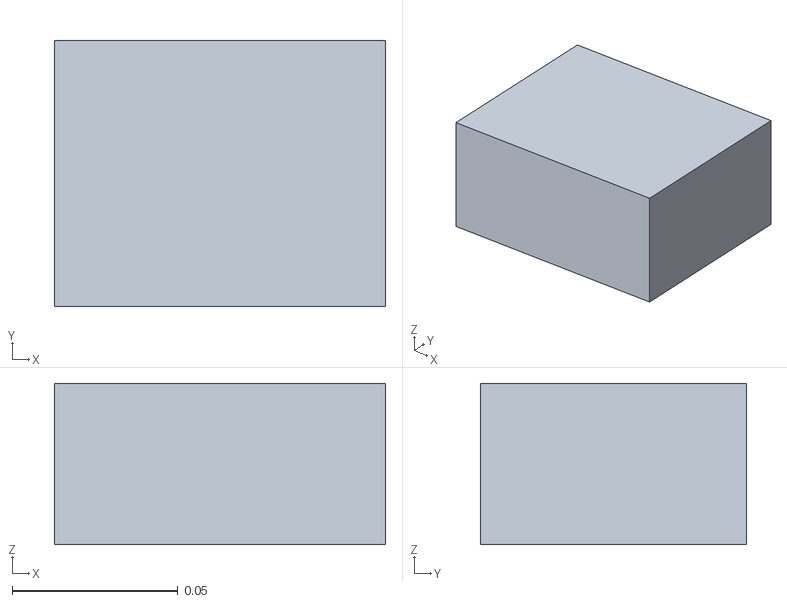
[picture p60: CAD file, 2024-10-20]
AeroShell_proj/New/ANSYS_wd/mesh.stl
0.1 x 0.0802 x 0.0488
