MDNich/MIT_Rkt_Aurora_Aero/AeroShell_proj/New/CylindreDummy.SLDPRT

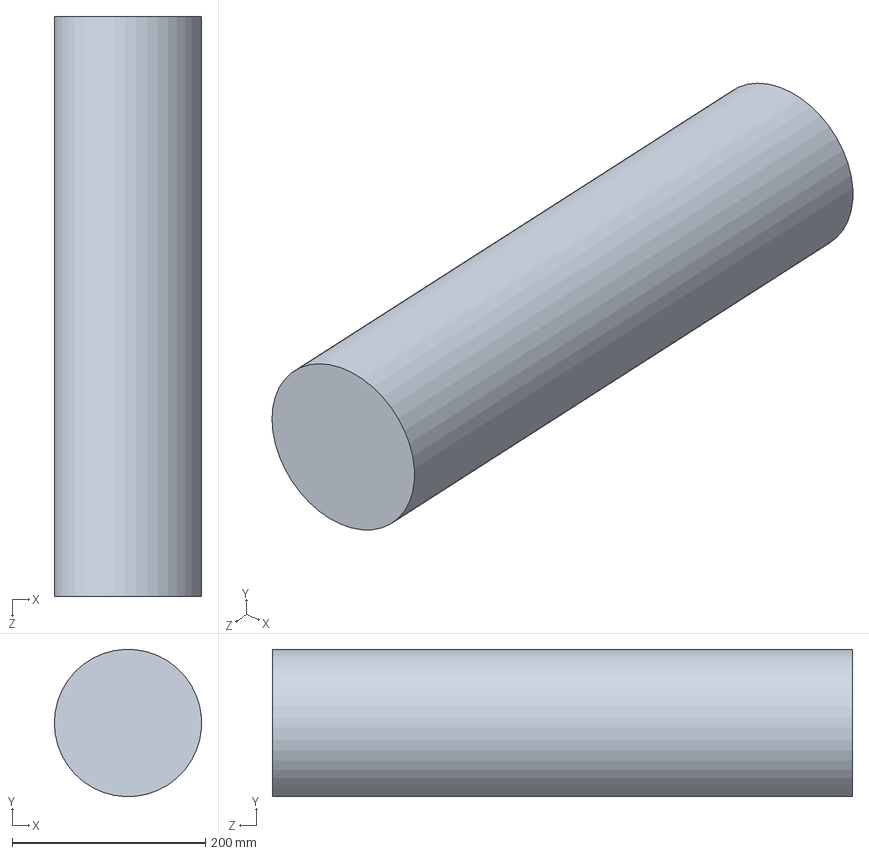
[picture p61: CAD file, 2024-10-05]
AeroShell_proj/New/CylindreDummy.SLDPRT
152.4 x 152.3 x 600.0 mm
