MDNich/MIT_Rkt_Aurora_Aero/FinCan/finCan_new_2024.12.04.09h50.SLDPRT

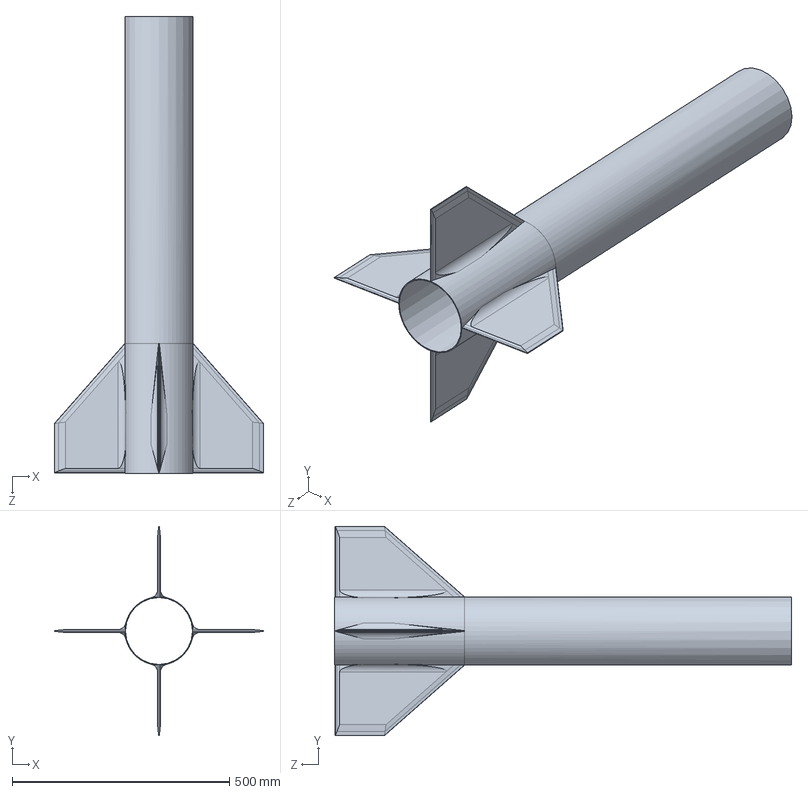
[picture p62: CAD file, 2024-12-04]
FinCan/finCan_new_2024.12.04.09h50.SLDPRT
481.6 x 481.6 x 1052.0 mm
