MDNich/MIT_Rkt_Aurora_Aero/jig/jigAssem.3mf

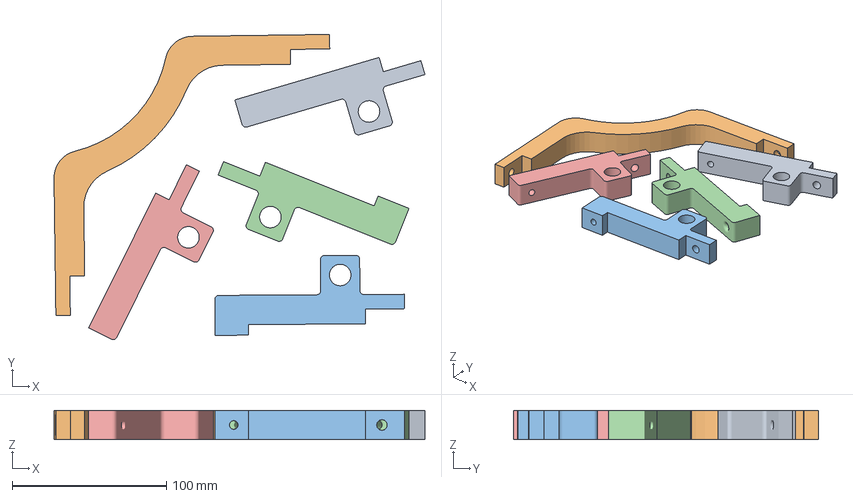
[picture p63: CAD file, 2025-02-01]
jig/jigAssem.3mf
240.4 x 197.7 x 19.1 mm
jig_1 x 2
jig_2
jig_3 x 2
