MDNich/MIT_Rkt_Aurora_Aero/tiptotip/justTube.STEP

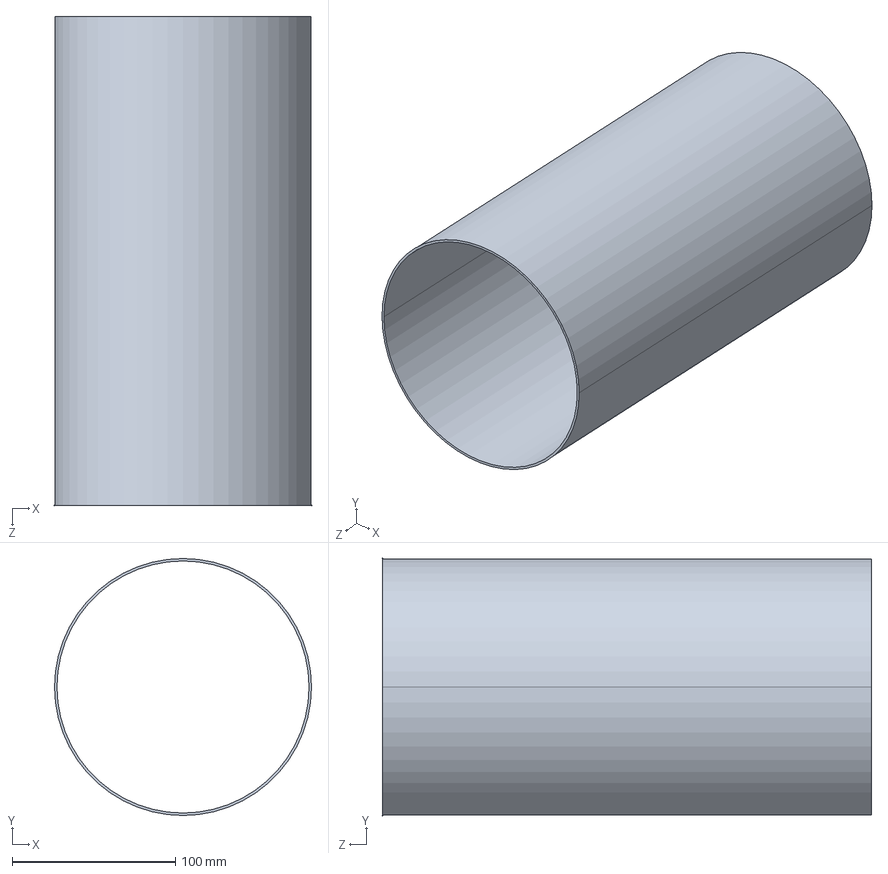
[picture p64: CAD file, 2025-03-09]
tiptotip/justTube.STEP
157.2 x 157.2 x 299.3 mm
