MDNich/MIT_Rkt_Aurora_Aero/aeroshell/Bstr_Aeroshell_Aurora_1.5_SKELETON_23Feb2025.STEP

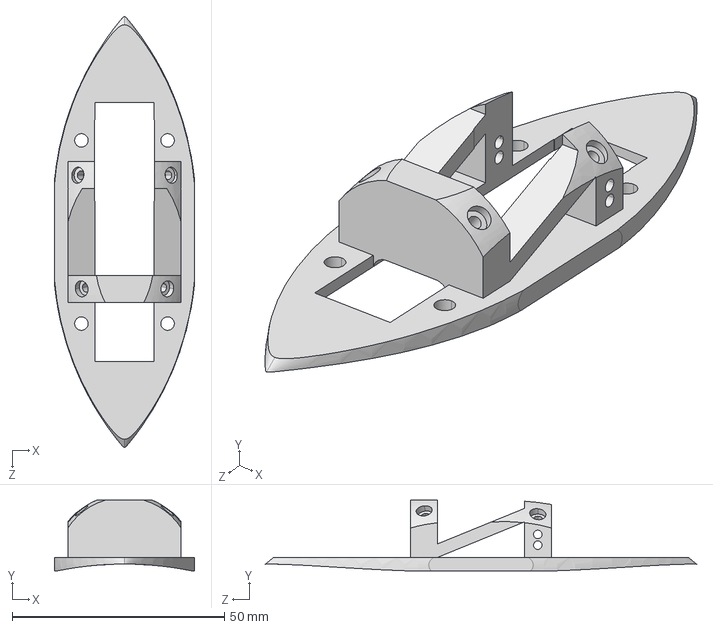
[picture p65: CAD file, 2025-05-06]
aeroshell/Bstr_Aeroshell_Aurora_1.5_SKELETON_23Feb2025.STEP
33.0 x 16.6 x 101.6 mm
