MDNich/MIT_Rkt_Aurora_Aero/AeroShell_proj/New/Skeleton1.0.SLDPRT

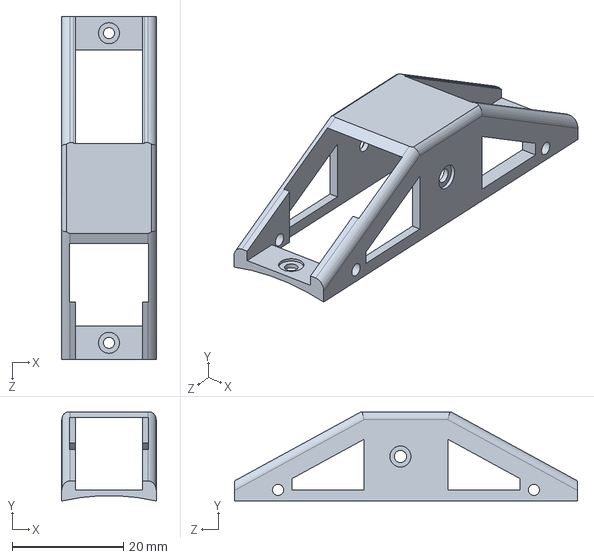
[picture p67: CAD file, 2024-10-05]
AeroShell_proj/New/Skeleton1.0.SLDPRT
17.0 x 16.0 x 61.7 mm
