MDNich/MIT_Rkt_Aurora_Aero/FinCan/finCan_justfin.STEP

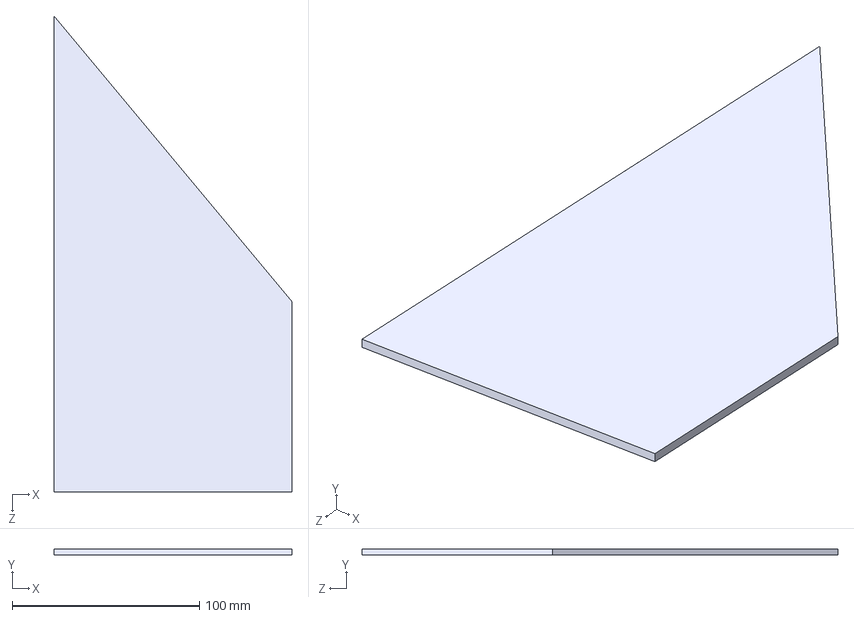
[picture p68: CAD file, 2024-11-23]
FinCan/finCan_justfin.STEP
127.0 x 3.17 x 254.0 mm
