MDNich/MIT_Rkt_Aurora_Aero/jig/jig_3.SLDPRT

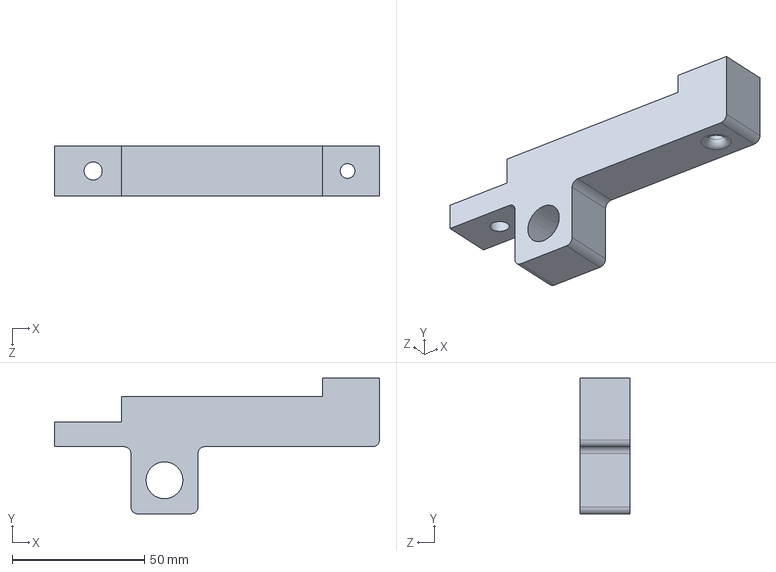
[picture p69: CAD file, 2025-02-01]
jig/jig_3.SLDPRT
122.8 x 51.3 x 19.1 mm
