MDNich/MIT_Rkt_Aurora_Aero/AeroShell_proj/New/ANSYS_wd/Aeroshell1.0_ANSYS_surfacefront.STEP

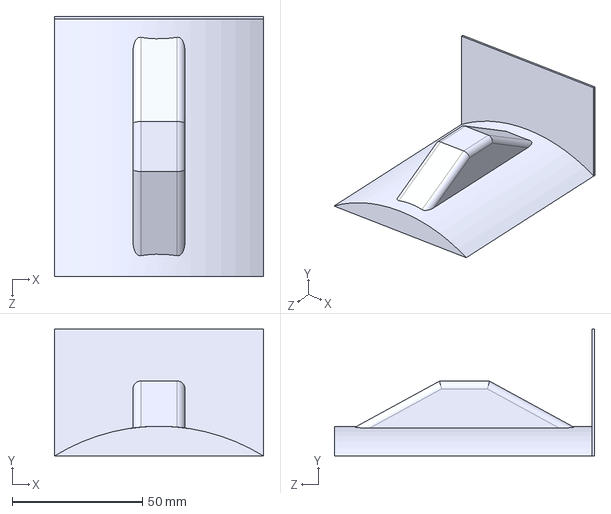
[picture p70: CAD file, 2024-10-20]
AeroShell_proj/New/ANSYS_wd/Aeroshell1.0_ANSYS_surfacefront.STEP
80.2 x 48.8 x 100.0 mm
