MDNich/MIT_Rkt_Aurora_Aero/AeroShell_proj/New/GlassPanel.SLDPRT

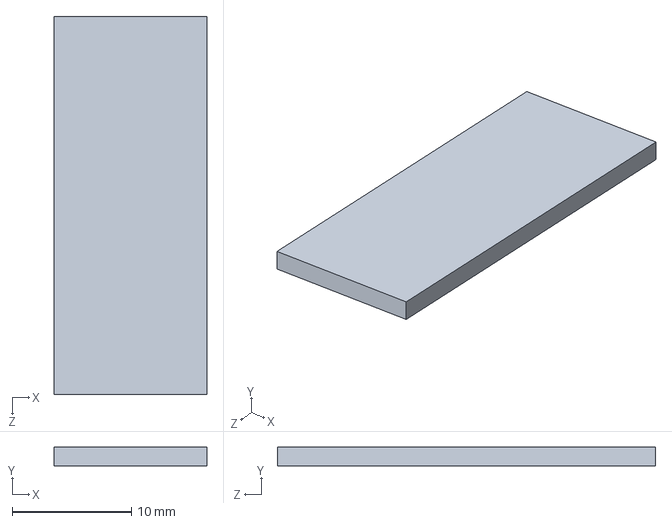
[picture p71: CAD file, 2024-10-05]
AeroShell_proj/New/GlassPanel.SLDPRT
12.8 x 1.59 x 31.8 mm
