MDNich/MIT_Rkt_Aurora_Aero/CureChamber/soquete.SLDPRT

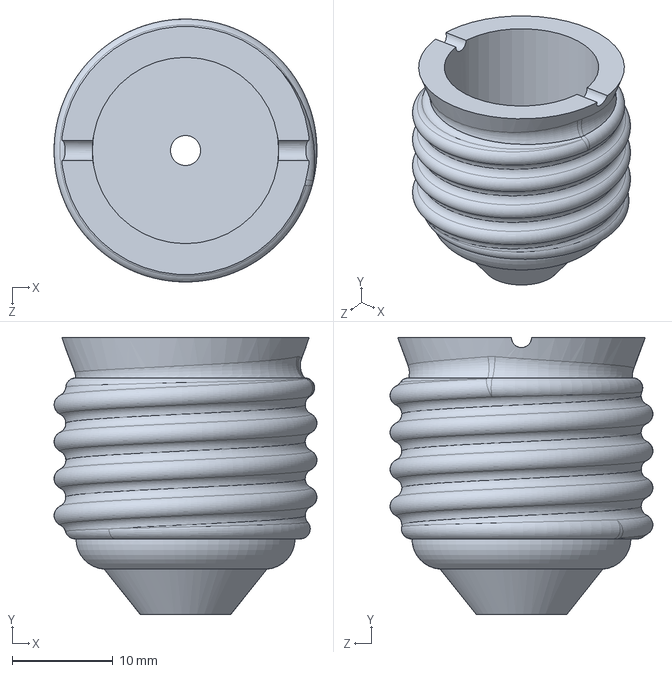
[picture p72: CAD file, 2024-11-23]
CureChamber/soquete.SLDPRT
26.1 x 27.5 x 26.1 mm
