MDNich/MIT_Rkt_Aurora_Aero/FinCan/finCan_new_2024.11.10.13h29.SLDPRT

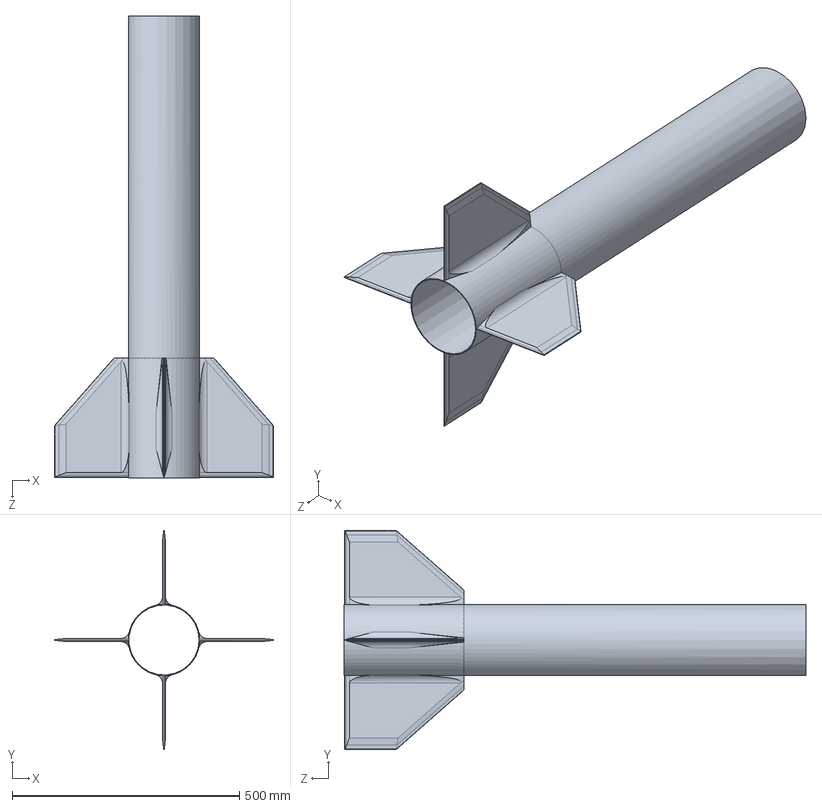
[picture p73: CAD file, 2024-11-23]
FinCan/finCan_new_2024.11.10.13h29.SLDPRT
481.6 x 481.6 x 1016.0 mm
