MDNich/MIT_Rkt_Aurora_Aero/jig/jig_2.SLDPRT

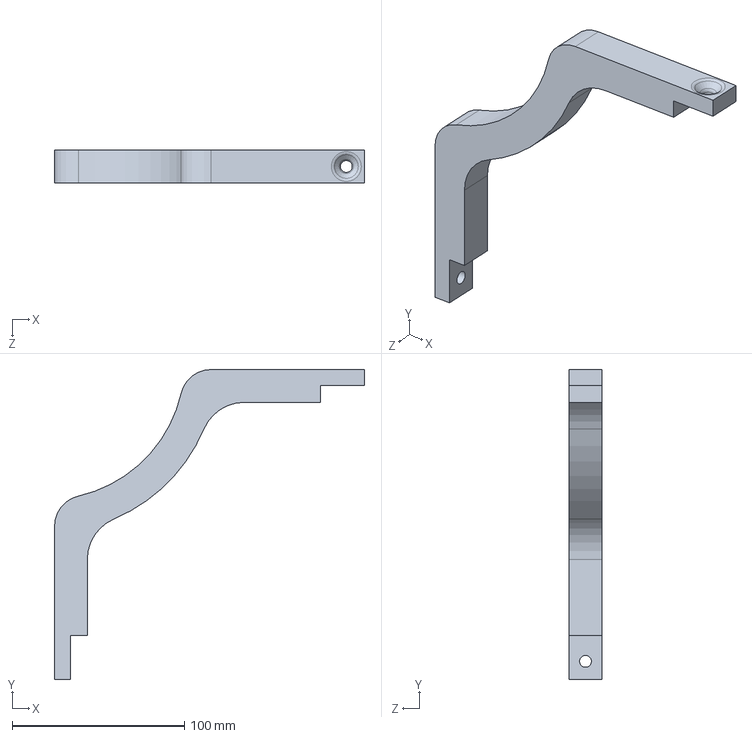
[picture p74: CAD file, 2025-01-24]
jig/jig_2.SLDPRT
179.8 x 179.8 x 19.1 mm
