MDNich/MIT_Rkt_Aurora_Aero/AeroShell_proj/New/ANSYS_wd/Aeroshell1.0_ANSYS_TWOBOXES.STEP

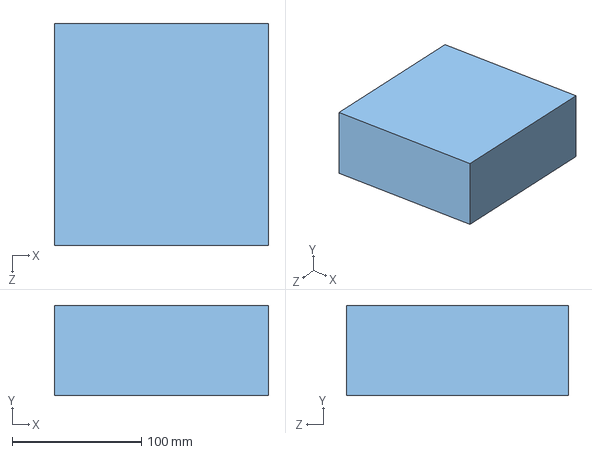
[picture p75: CAD file, 2024-10-20]
AeroShell_proj/New/ANSYS_wd/Aeroshell1.0_ANSYS_TWOBOXES.STEP
165.8 x 70.0 x 171.8 mm
