MDNich/MIT_Rkt_Aurora_Aero/CureChamber/bulb.SLDPRT

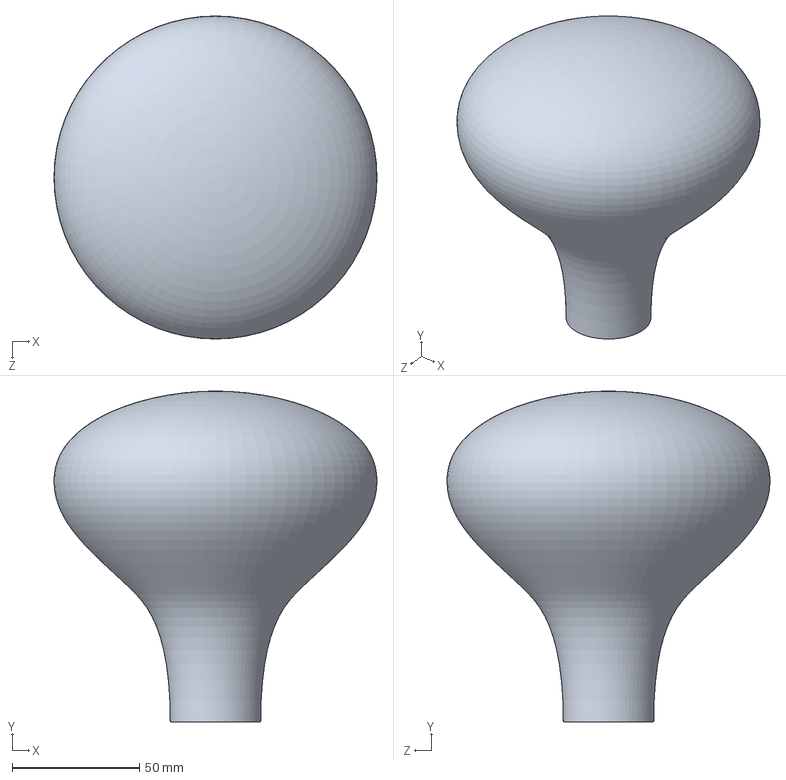
[picture p76: CAD file, 2024-11-23]
CureChamber/bulb.SLDPRT
127.0 x 130.1 x 127.0 mm
