MDNich/MIT_Rkt_Aurora_Aero/CureChamber/fiberglass.SLDPRT

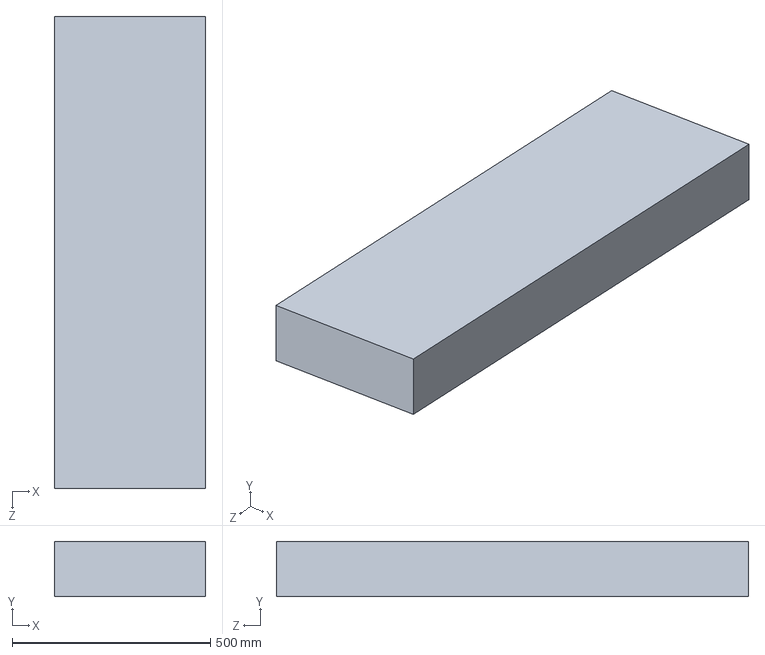
[picture p77: CAD file, 2024-11-11]
CureChamber/fiberglass.SLDPRT
381.0 x 139.7 x 1191.8 mm
