MDNich/MIT_Rkt_Aurora_Aero/FinCan/finCan_new_2024.11.09.16h44.SLDPRT

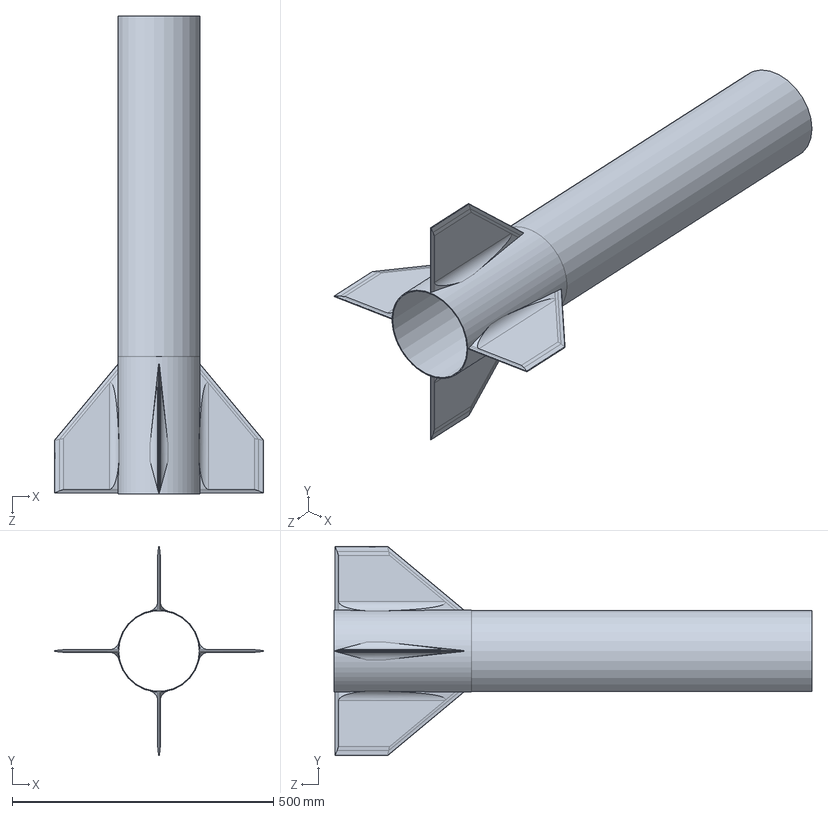
[picture p78: CAD file, 2024-11-11]
FinCan/finCan_new_2024.11.09.16h44.SLDPRT
400.3 x 400.3 x 914.4 mm
