MDNich/MIT_Rkt_Aurora_Aero/jig/finCanJigSmallPiece3Dprint.SLDPRT

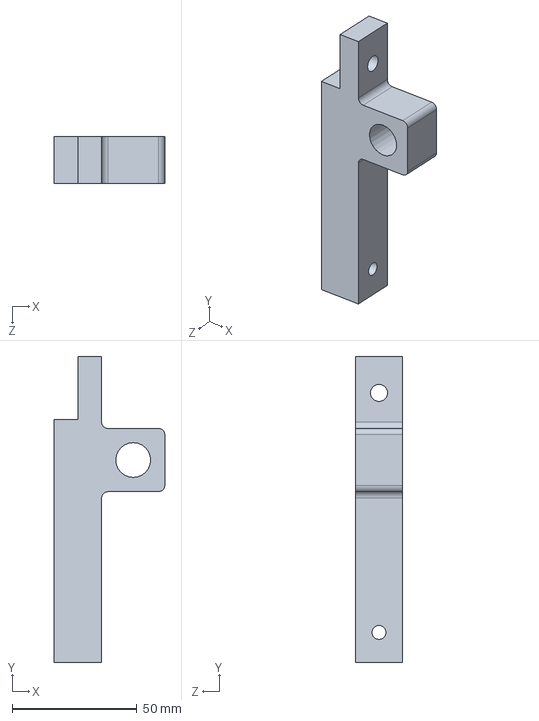
[picture p79: CAD file, 2025-01-24]
jig/finCanJigSmallPiece3Dprint.SLDPRT
44.5 x 122.8 x 19.1 mm
