MDNich/MIT_Rkt_Aurora_Aero/AeroShell_proj/New/ANSYS_wd/Aeroshell1.0_ANSYS_NEW.STEP

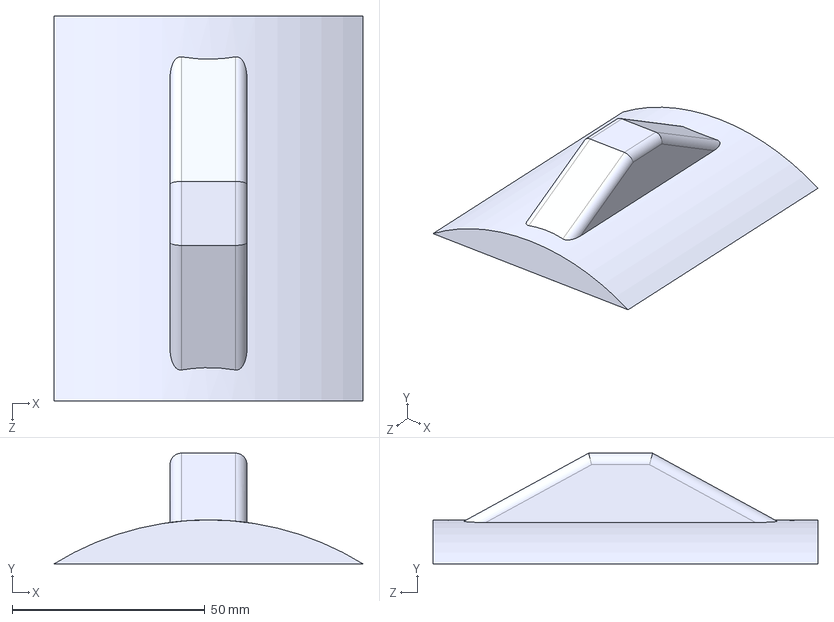
[picture p80: CAD file, 2024-10-19]
AeroShell_proj/New/ANSYS_wd/Aeroshell1.0_ANSYS_NEW.STEP
80.2 x 28.8 x 100.0 mm
