MDNich/MIT_Rkt_Aurora_Aero/CureChamber/8020.STEP

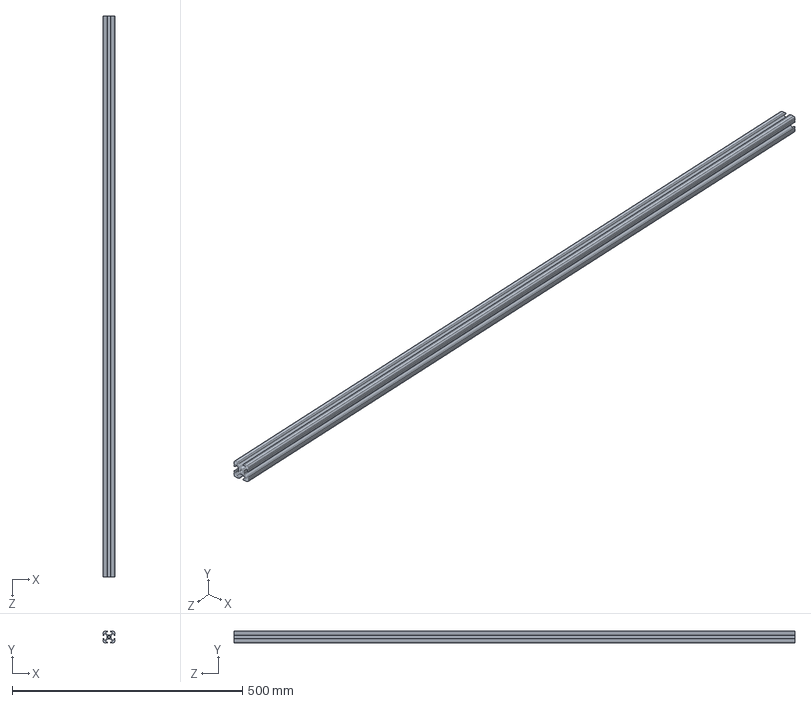
[picture p81: CAD file, 2024-11-11]
CureChamber/8020.STEP
25.4 x 25.4 x 1219.2 mm
