MDNich/MIT_Rkt_Aurora_Aero/FinCan/finCan_new.STEP

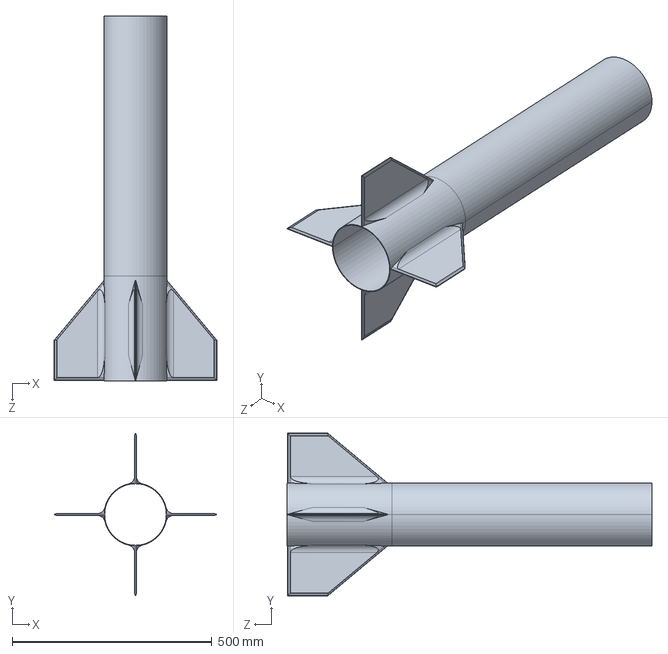
[picture p82: CAD file, 2024-11-09]
FinCan/finCan_new.STEP
407.6 x 407.6 x 914.4 mm
