MDNich/MIT_Rkt_Aurora_Aero/CureChamber/angle.STEP

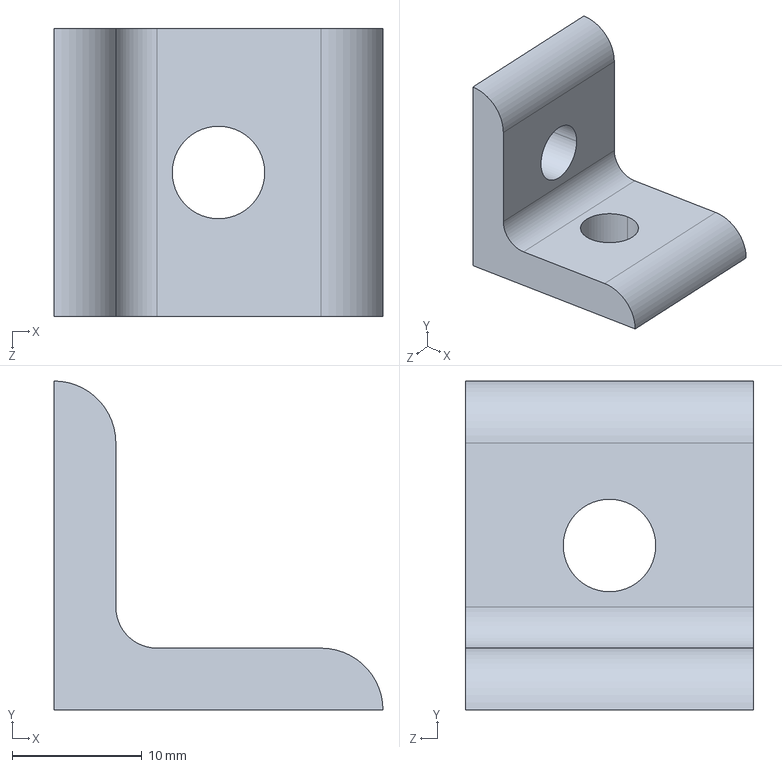
[picture p83: CAD file, 2024-11-11]
CureChamber/angle.STEP
25.4 x 25.4 x 22.2 mm
