MDNich/MIT_Rkt_Aurora_Aero/AeroShell_proj/New/ANSYS_wd/Aeroshell1.0.SLDPRT

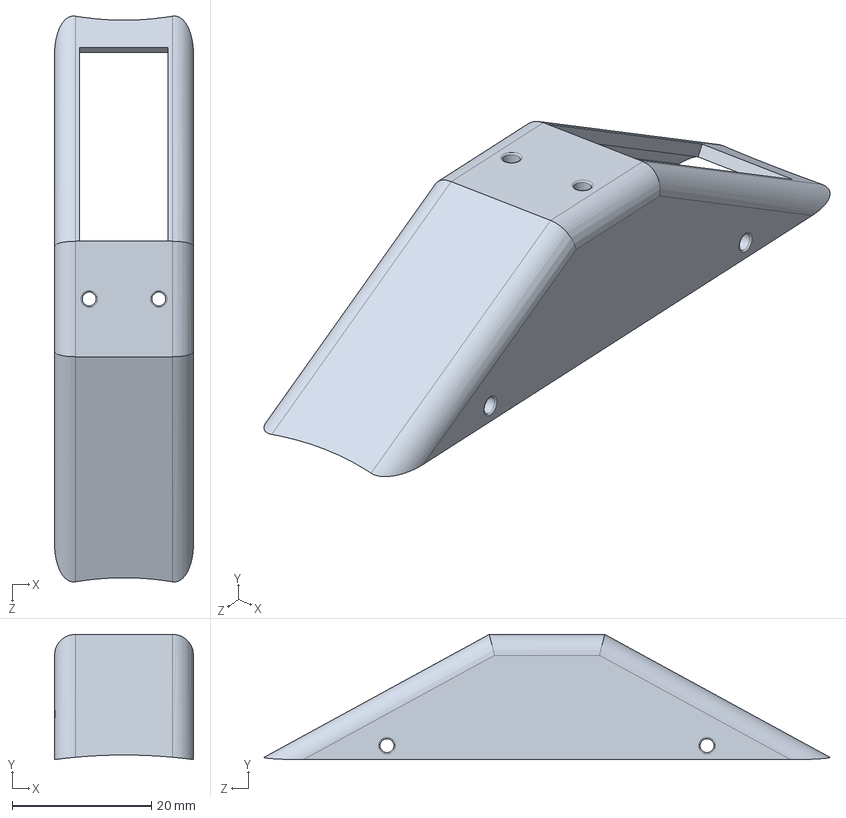
[picture p84: CAD file, 2024-10-05]
AeroShell_proj/New/ANSYS_wd/Aeroshell1.0.SLDPRT
20.0 x 18.0 x 81.4 mm
