MDNich/MIT_Rkt_Aurora_Aero/CureChamber/8020_2.SLDPRT

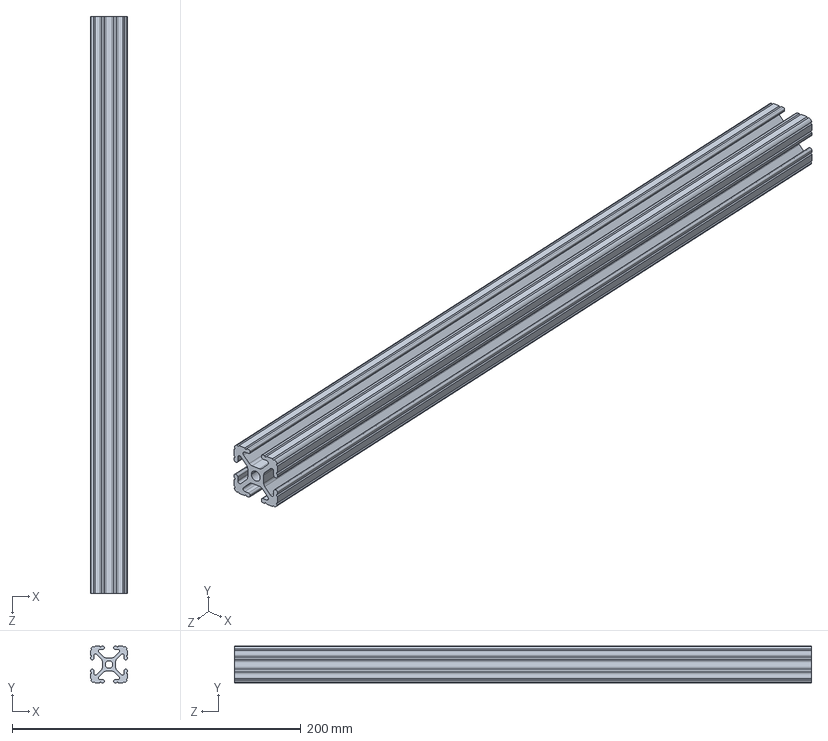
[picture p85: CAD file, 2024-11-11]
CureChamber/8020_2.SLDPRT
25.4 x 25.4 x 400.0 mm
