MDNich/MIT_Rkt_Aurora_Aero/jig/finCanJigLargePiece3Dprint.3MF

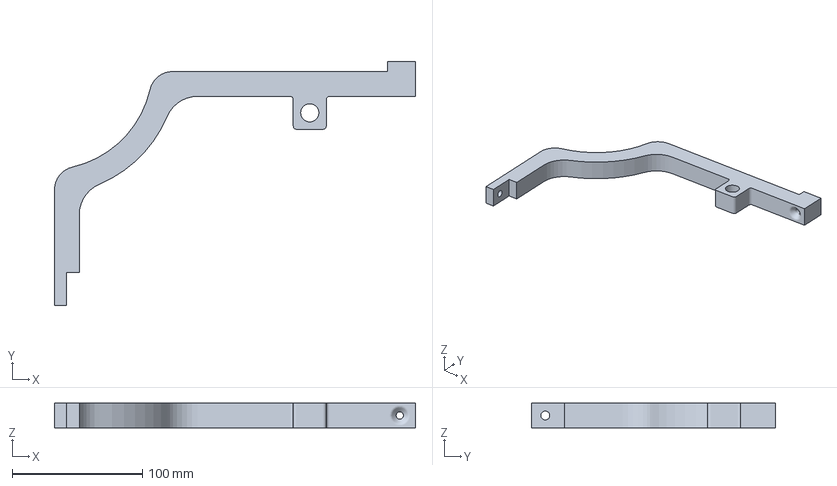
[picture p86: CAD file, 2024-12-20]
jig/finCanJigLargePiece3Dprint.3MF
277.5 x 187.4 x 19.0 mm
