MDNich/MIT_Rkt_Aurora_Aero/CureChamber/heatLamp.SLDPRT

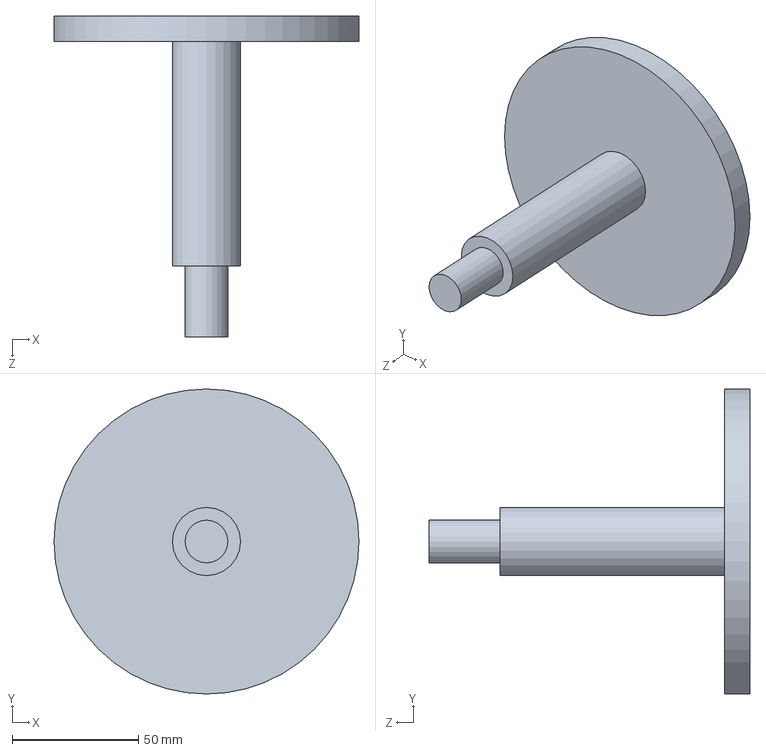
[picture p87: CAD file, 2024-11-11]
CureChamber/heatLamp.SLDPRT
120.7 x 120.7 x 127.0 mm
