MDNich/MIT_Rkt_Aurora_Aero/CureChamber/straightAttach.STEP

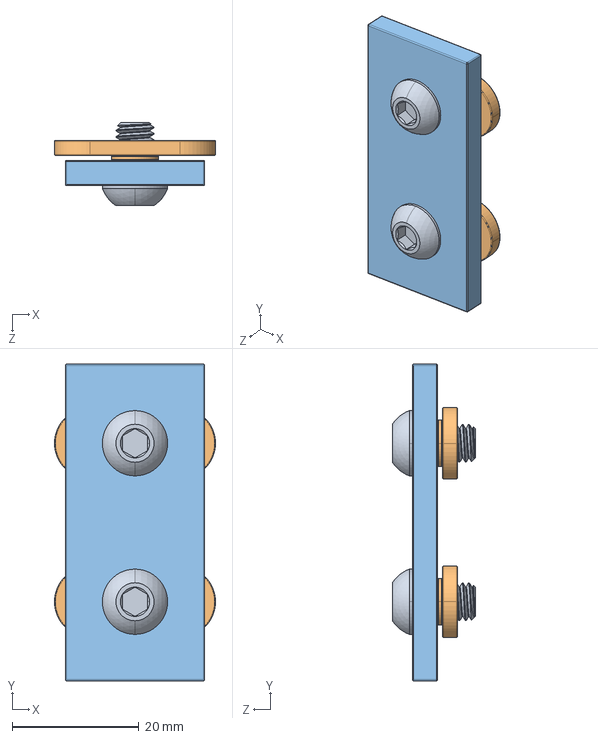
[picture p88: CAD file, 2024-11-11]
CureChamber/straightAttach.STEP
25.4 x 50.0 x 13.2 mm
