MDNich/MIT_Rkt_Aurora_Aero/FinCan/fin.SLDPRT

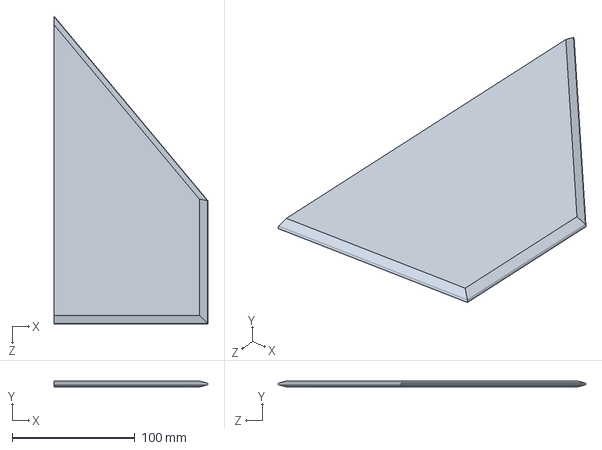
[picture p89: CAD file, 2024-10-26]
FinCan/fin.SLDPRT
125.3 x 5.00 x 250.7 mm
