MDNich/MIT_Rkt_Aurora_Aero/jig/finCanOutside.SLDPRT

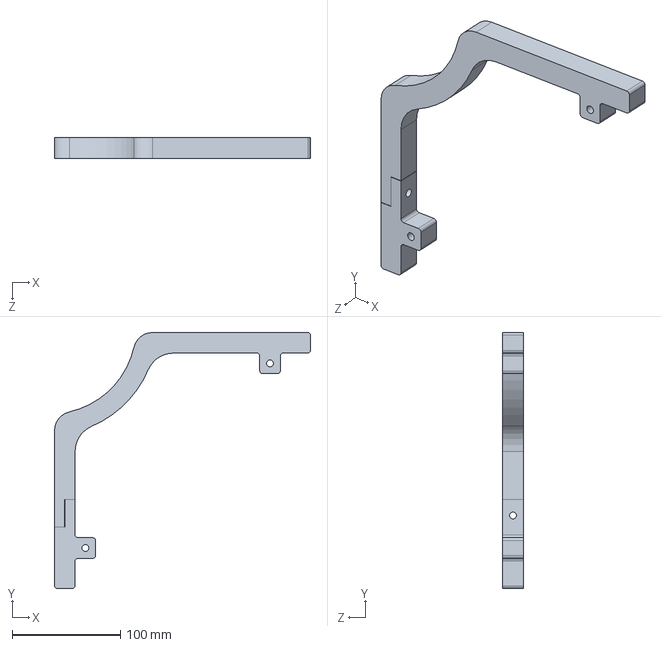
[picture p90: CAD file, 2024-12-15]
jig/finCanOutside.SLDPRT
236.9 x 236.9 x 19.1 mm
