MDNich/MIT_Rkt_Aurora_Aero/CureChamber/cover.SLDPRT

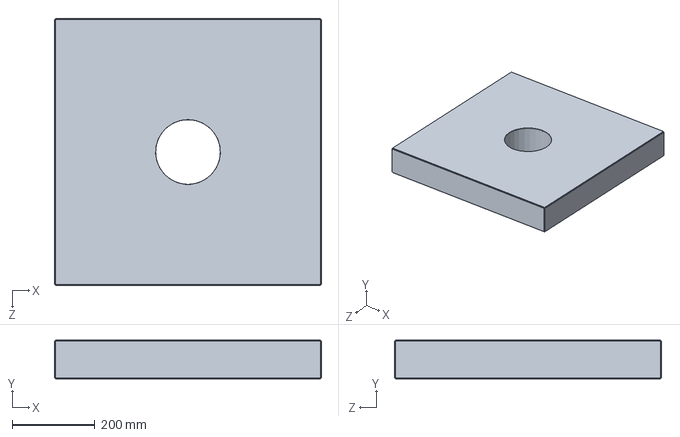
[picture p91: CAD file, 2024-11-11]
CureChamber/cover.SLDPRT
646.2 x 94.0 x 646.2 mm
