MDNich/MIT_Rkt_Aurora_Aero/FinCan/AirFrame.SLDPRT

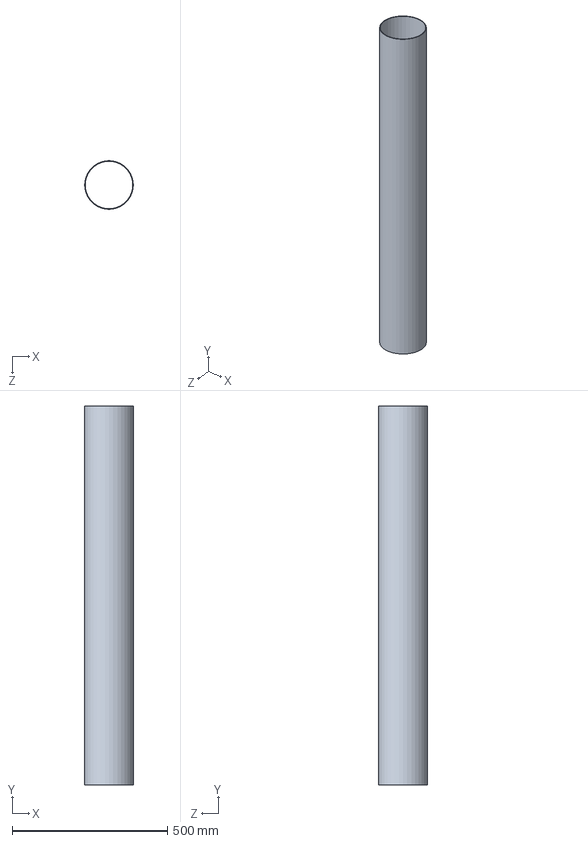
[picture p92: CAD file, 2024-10-26]
FinCan/AirFrame.SLDPRT
156.8 x 1219.2 x 156.8 mm
