MDNich/MIT_Rkt_Aurora_Aero/CureChamber/8020_3.SLDPRT

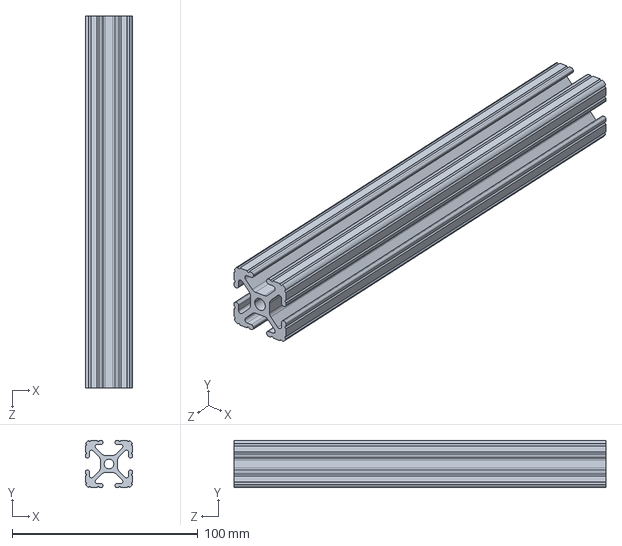
[picture p93: CAD file, 2024-11-11]
CureChamber/8020_3.SLDPRT
25.4 x 25.4 x 200.0 mm
