MDNich/MIT_Rkt_Aurora_Aero/CureChamber/8020_0.SLDPRT

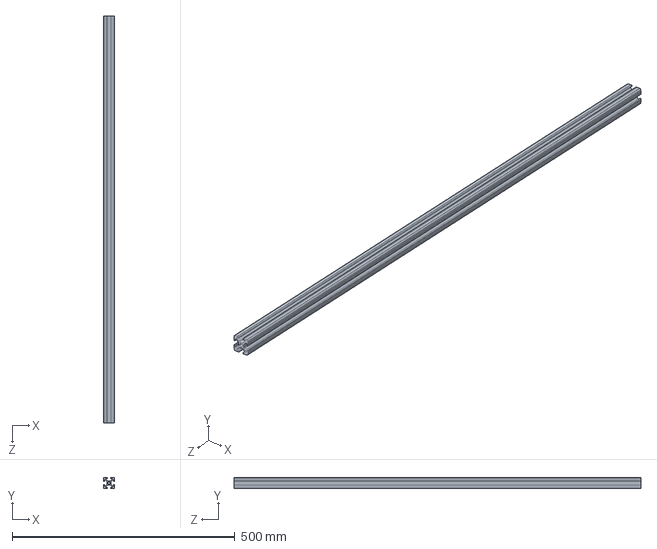
[picture p94: CAD file, 2024-11-11]
CureChamber/8020_0.SLDPRT
25.4 x 25.4 x 914.4 mm
