MDNich/MIT_Rkt_Aurora_Aero/CureChamber/8020_1.SLDPRT

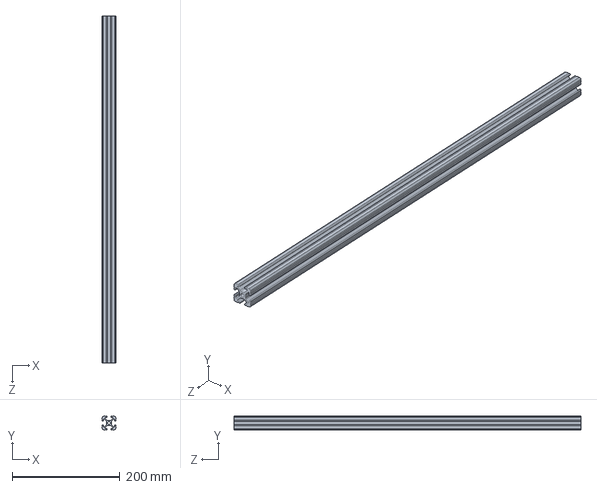
[picture p95: CAD file, 2024-11-11]
CureChamber/8020_1.SLDPRT
25.4 x 25.4 x 643.6 mm
