MDNich/MIT_Rkt_Aurora_Aero/CureChamber/attachToPlate.STEP

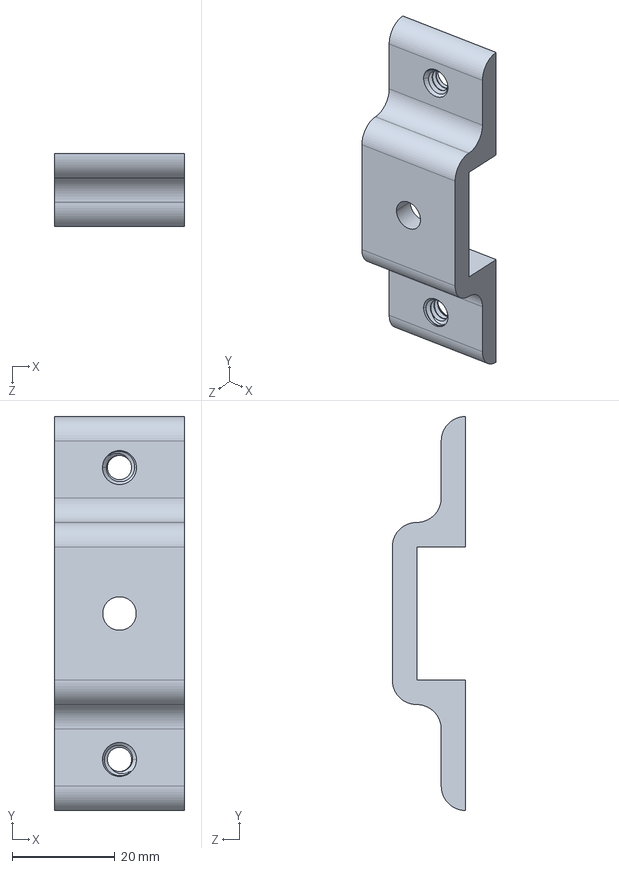
[picture p96: CAD file, 2024-11-11]
CureChamber/attachToPlate.STEP
25.4 x 76.7 x 14.3 mm
