MDNich/MIT_Rkt_Aurora_Aero/tiptotip/Assemblage1.SLDASM

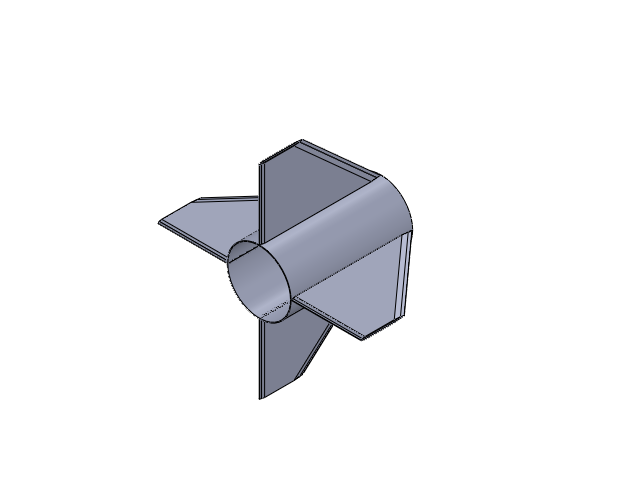
[picture p98: CAD file, 2025-03-09]
tiptotip/Assemblage1.SLDASM
justtube_
justfin_ x 4
