MDNich/MIT_Rkt_Aurora_Aero/CureChamber/CureChamberAssem_2024.11.11.18h42.SLDASM

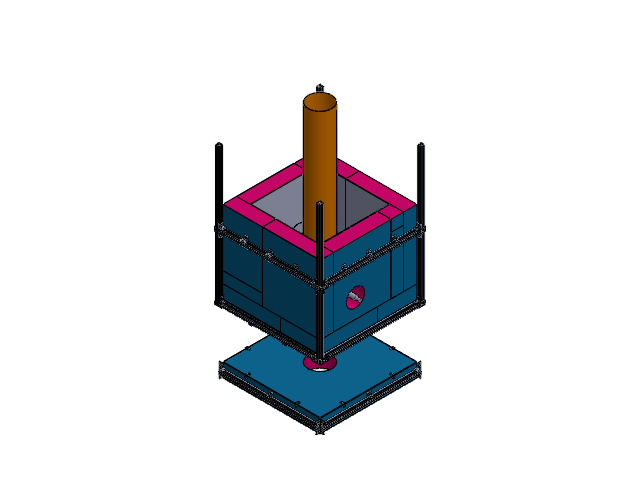
[picture p99: CAD file, 2024-11-11]
CureChamber/CureChamberAssem_2024.11.11.18h42.SLDASM
chamber
finCan_new_2024.11.10.13h29
angle x 89
straightattach x 20
cover
1556A26_Zinc-Plated Steel Corner Bracket x 8
Blades.step
Housing.step
heatLamp x 2
