MDNich/MIT_Rkt_Aurora_Aero/CureChamber/fan.SLDASM

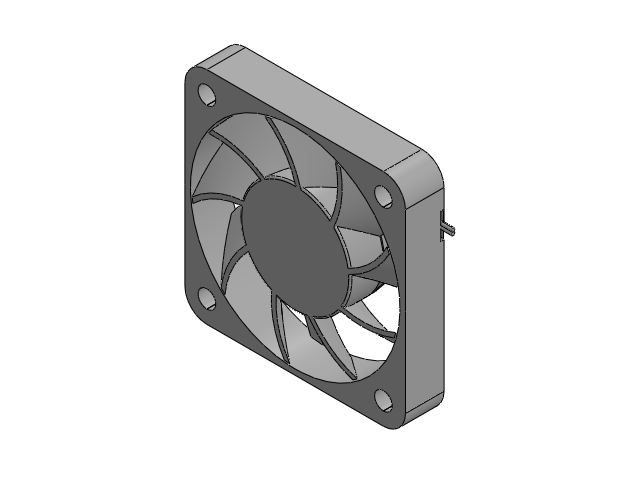
[picture p100: CAD file, 2024-11-11]
CureChamber/fan.SLDASM
Blades.step
Housing.step
