MDNich/MIT_Rkt_Aurora_Aero/(list of files, cad)

Other CAD files:
finCan_1p7/assemFus.SLDASM
finCan_1p7/aura-aerod-finCan-v1.9.SLDPRT
tiptotip/justFin.STEP
aeroshell/bstr_aeroshell_aurora_1.5_skeleton_03.04.2025.SLDPRT
finCan_1p7/aura-aerod-finCan-v1.8.STEP
FinCan/finCan_new_2024.11.23.15h23.STEP
AeroShell_proj/New/ANSYS_wd/Aeroshell1.0_ANSYS.STEP
jig/jig_1.SLDPRT
FinCan/finCan_new_2024.11.09.15h41.SLDPRT
jig/Fillet7.SLDPRT
FinCan/finCanAssem.SLDPRT
jig/finCanJigLargePiece3Dprint_mirrorVersion.SLDPRT
jig/finCanOutsideJust.SLDPRT
AeroShell_proj/New/ANSYS_wd/Aeroshell1.0_ANSYS.SLDPRT
AeroShell_proj/New/Aeroshell1.0_ANSYS.SLDPRT
AeroShell_proj/Old/Aeroshell_Prometheus_Assem_FINAL_12Apr2024.SLDASM
AeroShell_proj/Old/Bstr_Aeroshell_Prometheus_1.1_HOLLOW_SHELL_29Jan2024.SLDPRT
AeroShell_proj/Old/Bstr_Aeroshell_Prometheus_1.1_SKELETON_29Jan2024.SLDPRT
AeroShell_proj/Old/Bstr_Aeroshell_Prometheus_1.3_SKELETON_12Apr2024.SLDPRT
AeroShell_proj/Old/Glass_Cover_Aeroshell_Medusa.SLDPRT
AeroShell_proj/Old/Test_MPT_Prometheus.SLDPRT
AeroShell_proj/Old/ansys_wd/assemblage.SLDASM
AeroShell_proj/Old/ansys_wd/coquille.SLDPRT
AeroShell_proj/Old/ansys_wd/coquille.STEP
AeroShell_proj/Old/ansys_wd/coquille_jouer.SLDPRT
AeroShell_proj/Old/ansys_wd/old_ansys.SLDPRT
CureChamber/angle.SLDPRT
CureChamber/attachtoplate.SLDPRT
CureChamber/lamp.SLDPRT
CureChamber/straightattach.SLDPRT
FinCan/AssemblageEnPartie.SLDPRT
FinCan/finCan_justfin.SLDPRT
FinCan/finCan_new.3MF
FinCan/finCan_new.SLDPRT
FinCan/finCan_new.STL
FinCan/finCan_new_2024.11.23.15h23.SLDPRT
Templates/MIT RT Drawing Template.SLDDRW
aeroshell/bstr_aeroshell_aurora_1.5_skeleton_27.04.2025.SLDPRT
finCan_1p7/aura-aerod-finCan-v1.7.SLDPRT
finCan_1p7/aura-aerod-finCan-v1.8.SLDPRT
jig/finCanJigSmallPiece3Dprint.3MF
jig/jig_1.3MF
jig/jig_2.3MF
jig/jig_3.3MF
tiptotip/justFin.SLDPRT
tiptotip/justTube.SLDPRT
tiptotip/justfin.STL
tiptotip/justfin_.SLDPRT
tiptotip/justtube_.SLDPRT
tiptotip/justtube_.STL
