MDNich/MIT_Rkt_Aurora_Aero/FinCan/analysisResults/bL1_b.png

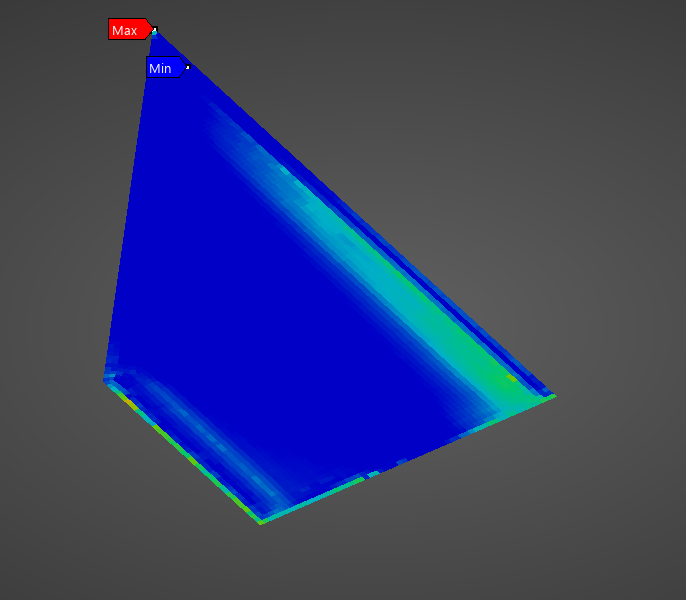
FinCan/analysisResults/bL1_b.png
