MDNich/MIT_Rkt_Aurora_Aero/FinCan/analysisResults/bL2_b.png

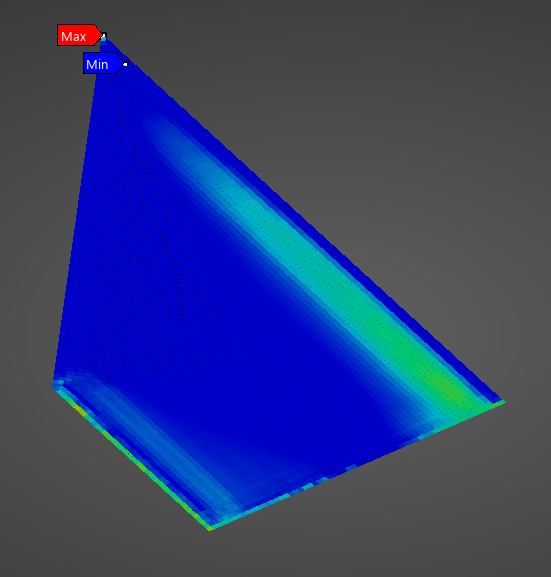
FinCan/analysisResults/bL2_b.png
