MDNich/MIT_Rkt_Aurora_Aero/FinCan/analysisResults/bL3_b.png

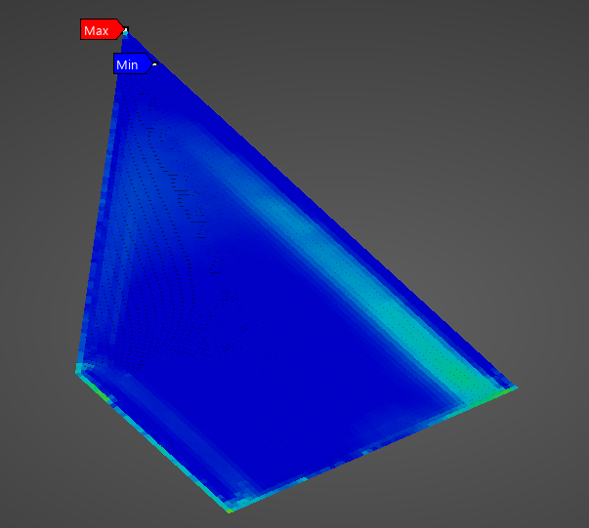
FinCan/analysisResults/bL3_b.png
