MDNich/MIT_Rkt_Aurora_Aero/FinCan/analysisResults/bL4_b.png

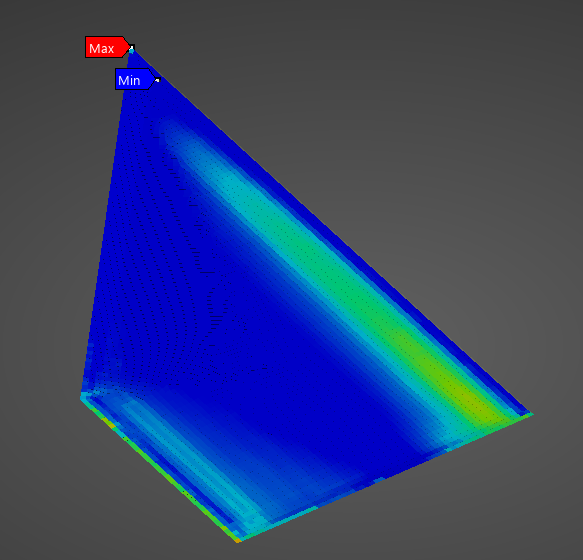
FinCan/analysisResults/bL4_b.png
