MDNich/MIT_Rkt_Aurora_Aero/FinCan/analysisResults/bL5_b.png

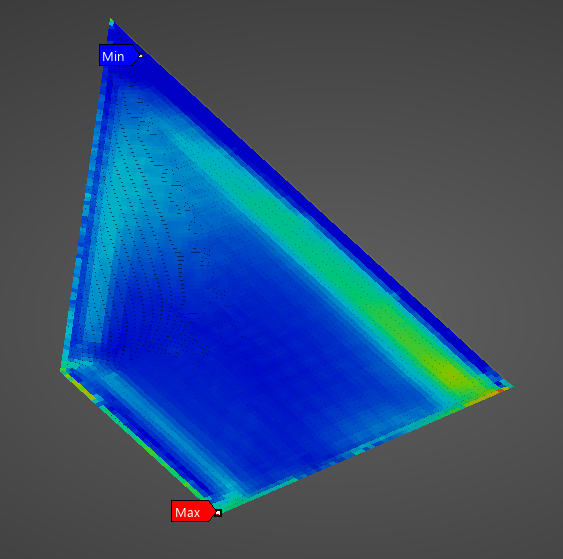
FinCan/analysisResults/bL5_b.png
