MDNich/MIT_Rkt_Aurora_Aero/FinCan/analysisResults/bL6_b.png

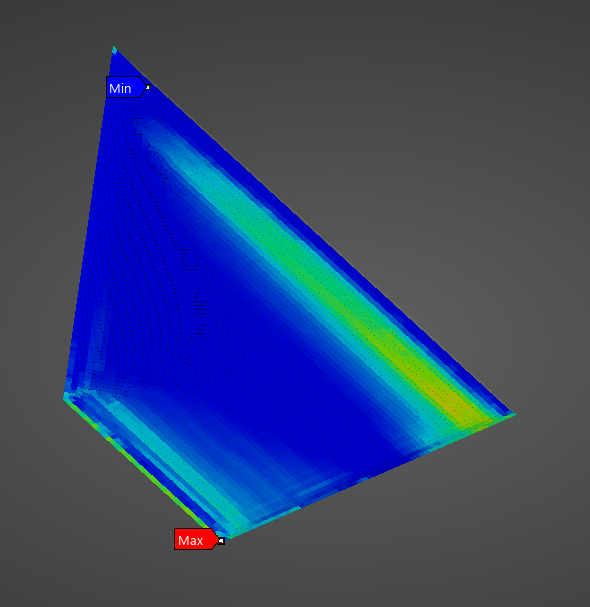
FinCan/analysisResults/bL6_b.png
