MDNich/MIT_Rkt_Aurora_Aero/FinCan/analysisResults/bL7_b.png

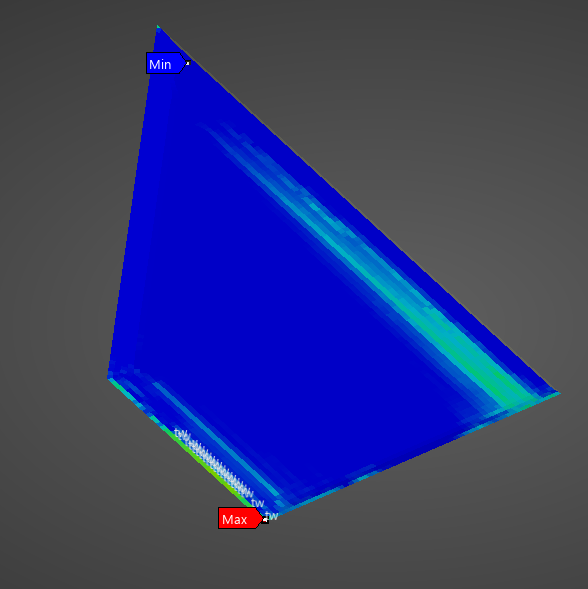
FinCan/analysisResults/bL7_b.png
