MDNich/MIT_Rkt_Aurora_Aero/FinCan/analysisResults/hL1_h.png

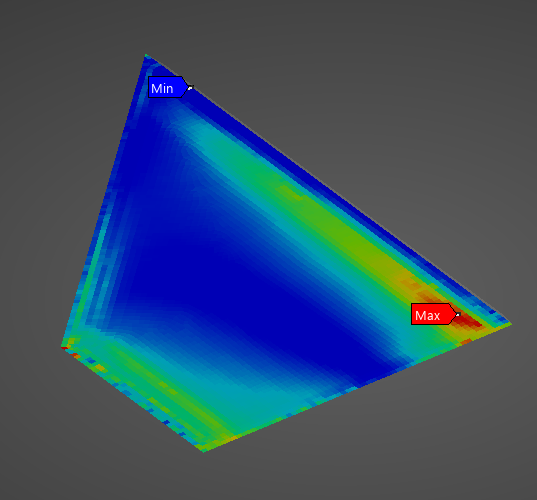
FinCan/analysisResults/hL1_h.png
