MDNich/MIT_Rkt_Aurora_Aero/FinCan/analysisResults/hL2_h.png

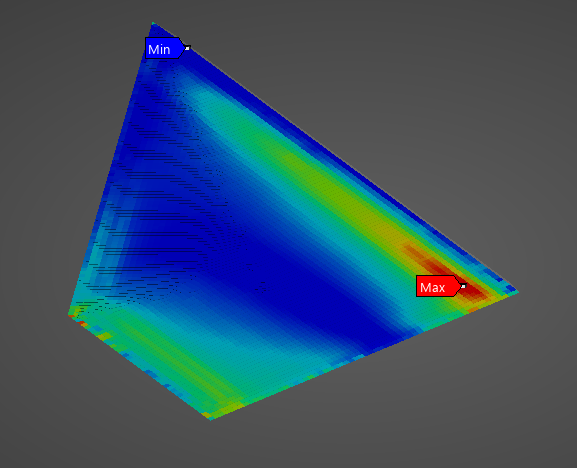
FinCan/analysisResults/hL2_h.png
