MDNich/MIT_Rkt_Aurora_Aero/FinCan/analysisResults/hL3_h.png

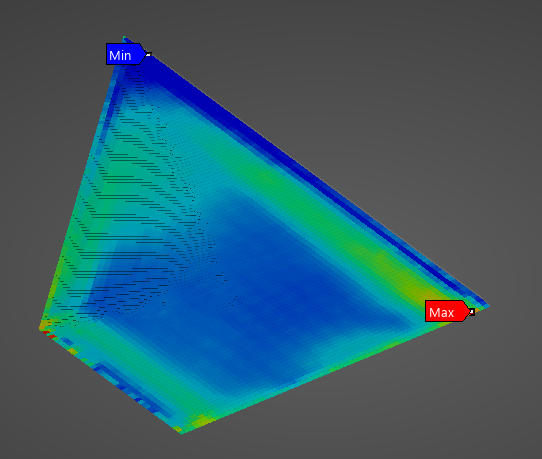
FinCan/analysisResults/hL3_h.png
