MDNich/MIT_Rkt_Aurora_Aero/FinCan/analysisResults/hL4_h.png

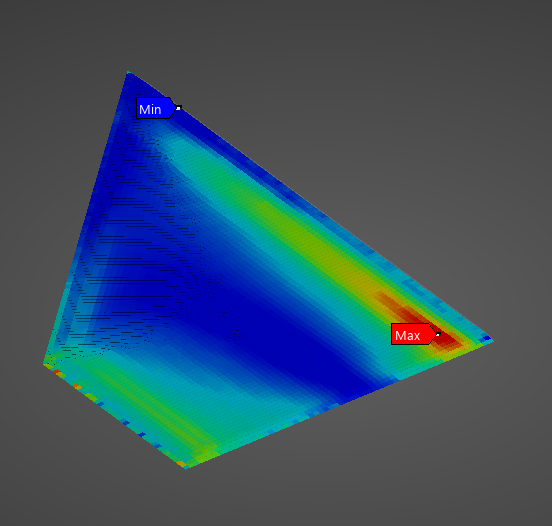
FinCan/analysisResults/hL4_h.png
