MDNich/MIT_Rkt_Aurora_Aero/FinCan/analysisResults/hL5_h.png

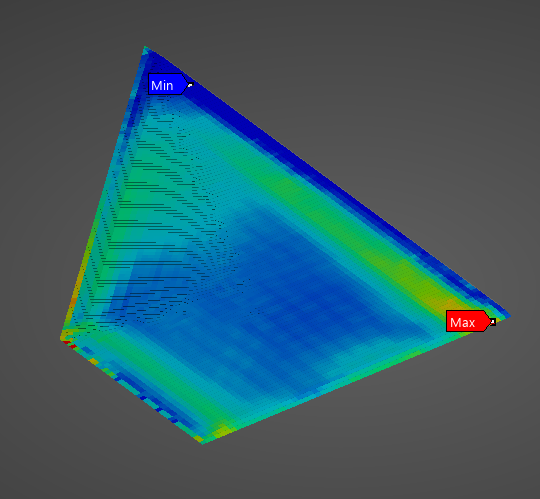
FinCan/analysisResults/hL5_h.png
