MDNich/MIT_Rkt_Aurora_Aero/FinCan/analysisResults/hL6_h.png

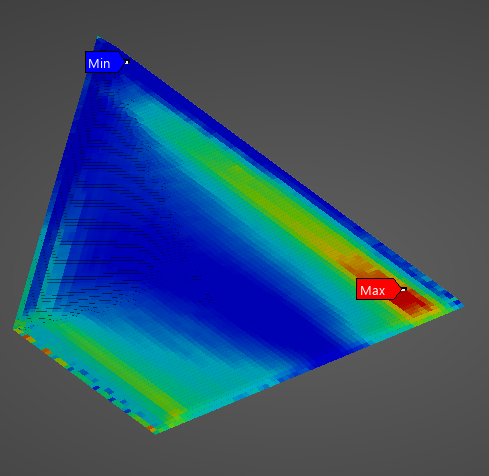
FinCan/analysisResults/hL6_h.png
