MDNich/MIT_Rkt_Aurora_Aero/FinCan/analysisResults/hL7_h.png

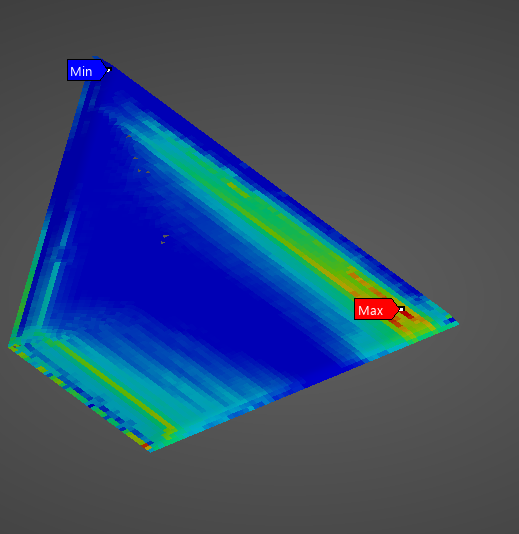
FinCan/analysisResults/hL7_h.png
