MDNich/MIT_Rkt_Aurora_Aero/FinCan/analysisResults/totFail.png

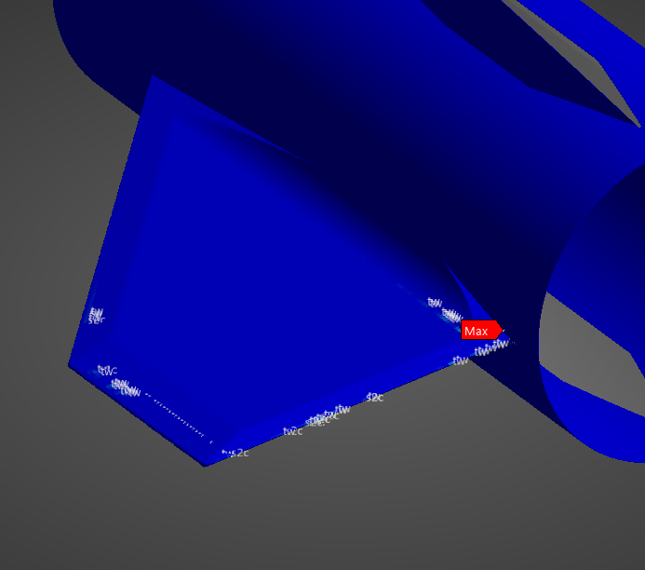
FinCan/analysisResults/totFail.png
