MDNich/MIT_Rkt_Aurora_Aero/AeroShell_proj/New/ANSYS_wd/problem_setup_files/progress_files/dp0/FFF/Fluent/pathlines-1.png

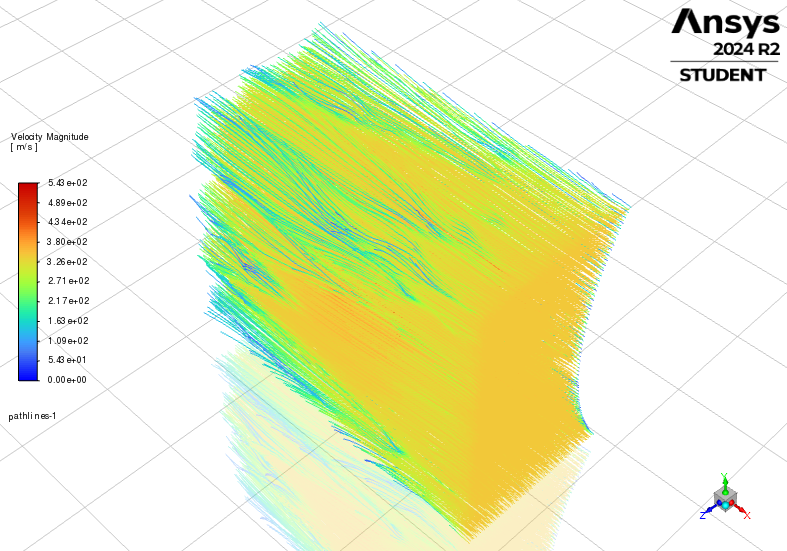
AeroShell_proj/New/ANSYS_wd/problem_setup_files/progress_files/dp0/FFF/Fluent/pathlines-1.png
