MDNich/MIT_Rkt_Aurora_Aero/AeroShell_proj/Analysis/src/out/figure2_pressure_Abs_3D.pdf

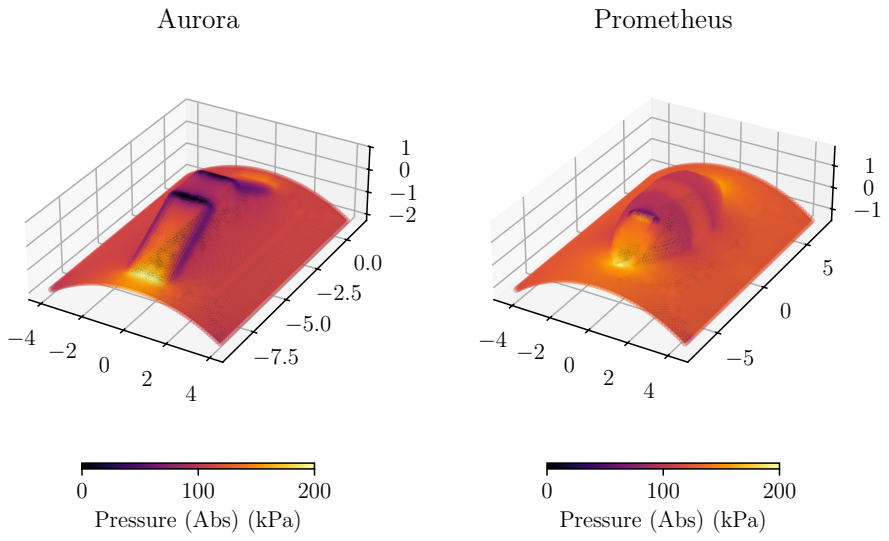
[picture p117: page 1]
Aurora; Prometheus

Pressure (Abs) (kPa)
