MDNich/MIT_Rkt_Aurora_Aero/AeroShell_proj/Analysis/src/out/figure2_pressure_Dynamic_3D.pdf

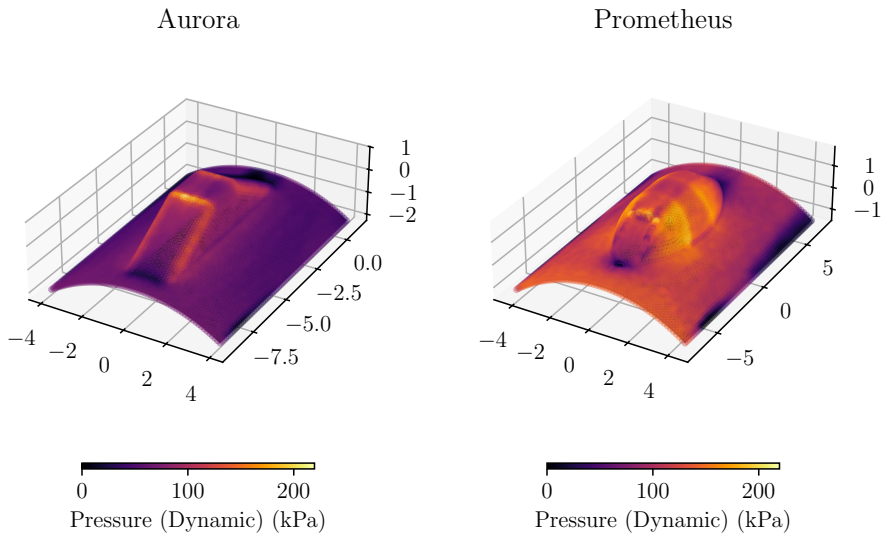
[picture p118: page 1]
Aurora; Prometheus

Pressure (Dynamic) (kPa)
