MDNich/MIT_Rkt_Aurora_Aero/AeroShell_proj/Analysis/src/out/figure2_pressure_Total_3D.pdf

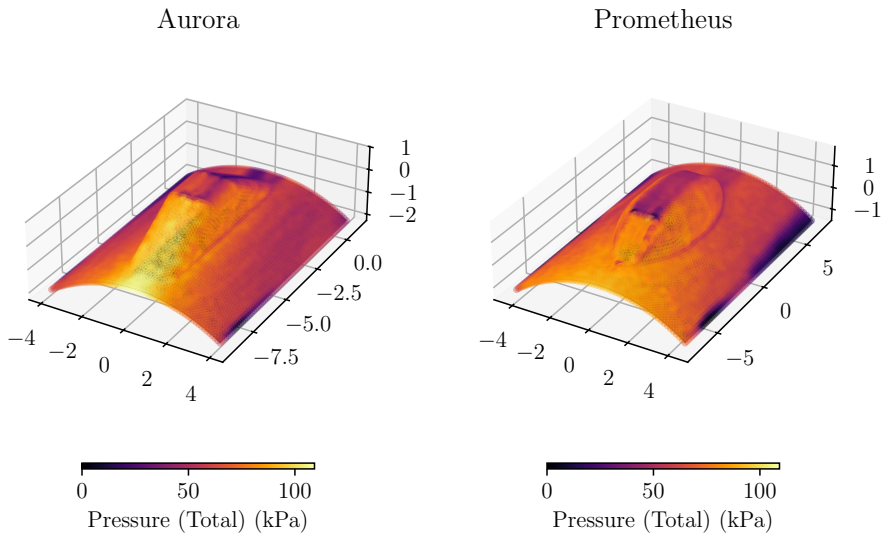
[picture p119: page 1]
Aurora; Prometheus

Pressure (Total) (kPa)
