MDNich/MIT_Rkt_Aurora_Aero/AeroShell_proj/Analysis/src/py/figure1.pdf

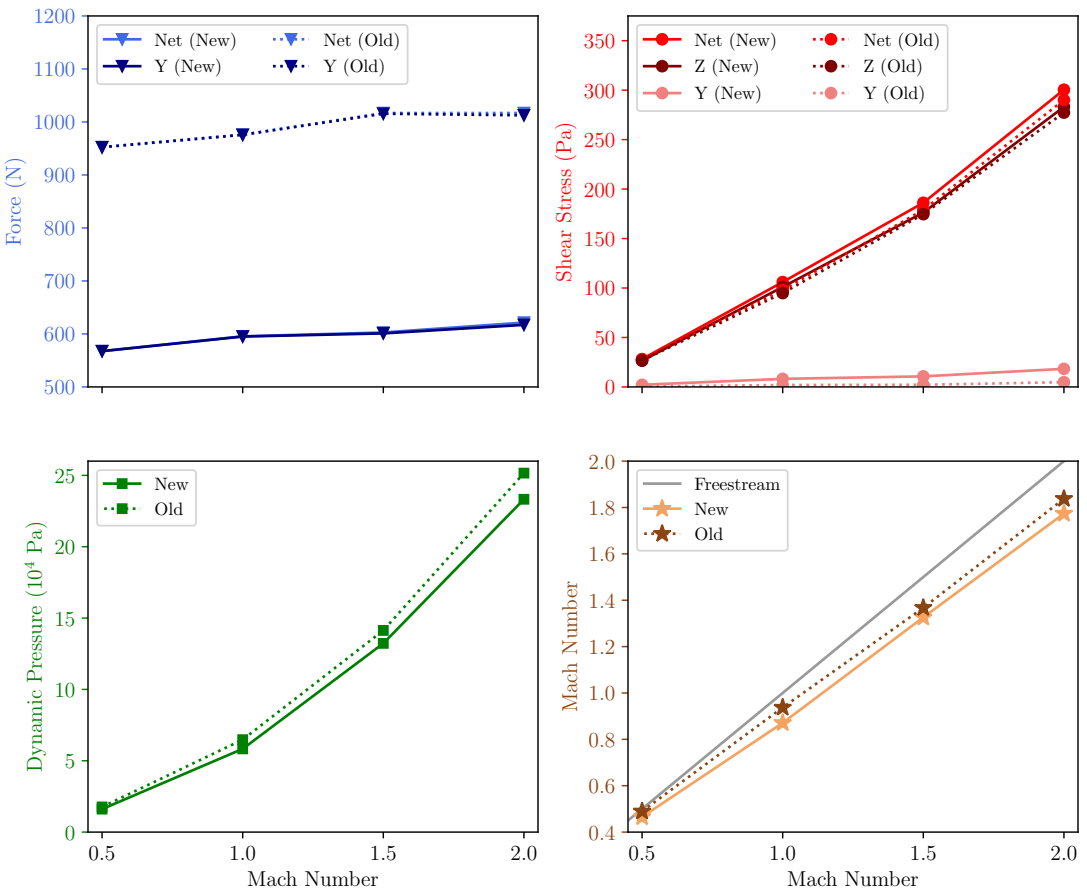
[picture p120: page 1]
Force (N); Net (New) Y (New); Net (Old) Y (Old); Net (New) Z (New) Y (New); Net (Old) Z (Old) Y (Old); Mach Number; New Old; Freestream New Old

Shear Stress (Pa)

Dynamic Pressure (104 Pa)
