MDNich/MIT_Rkt_Aurora_Aero/pic/booster.pdf

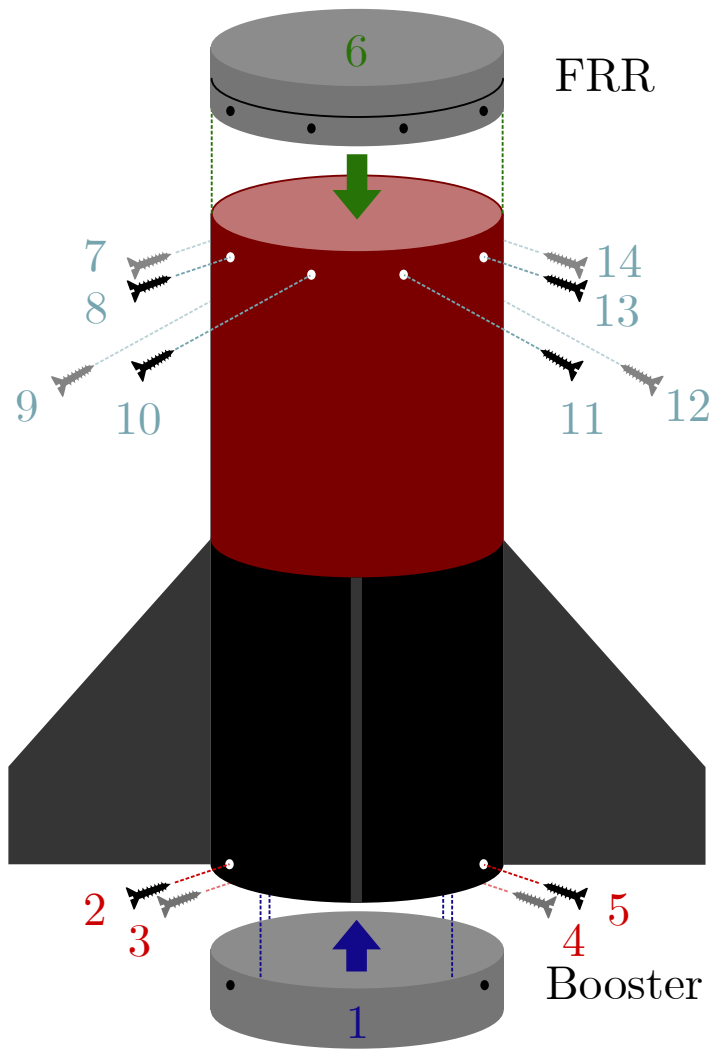
[picture p121: page 1]
Booster; FRR
