MDNich/MIT_Rkt_Aurora_Aero/FEA_docs/0p90.pdf

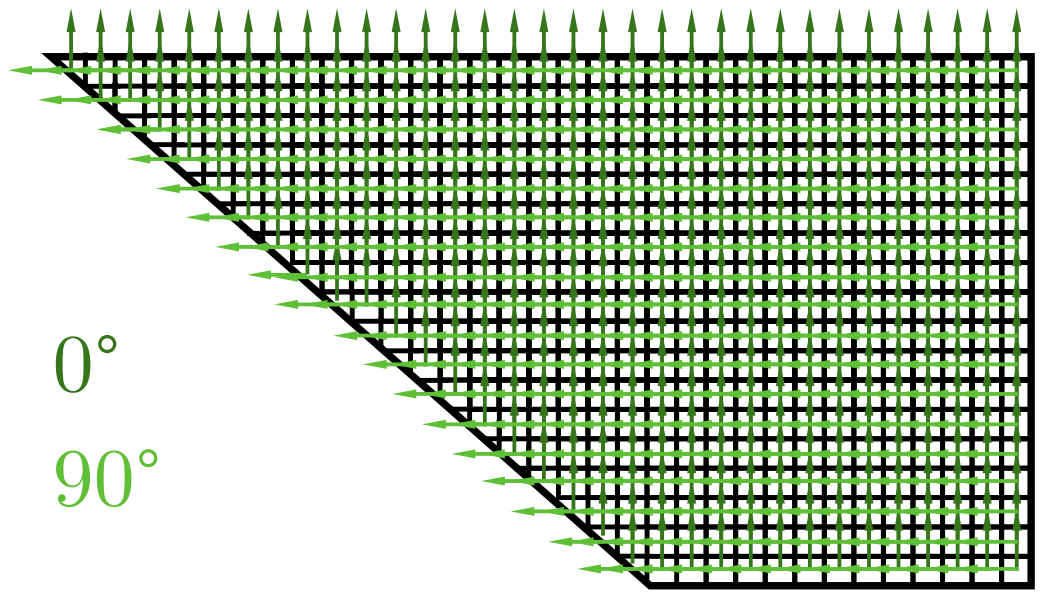
[picture p122: page 1]
