MDNich/MIT_Rkt_Aurora_Aero/FEA_docs/45p45.pdf

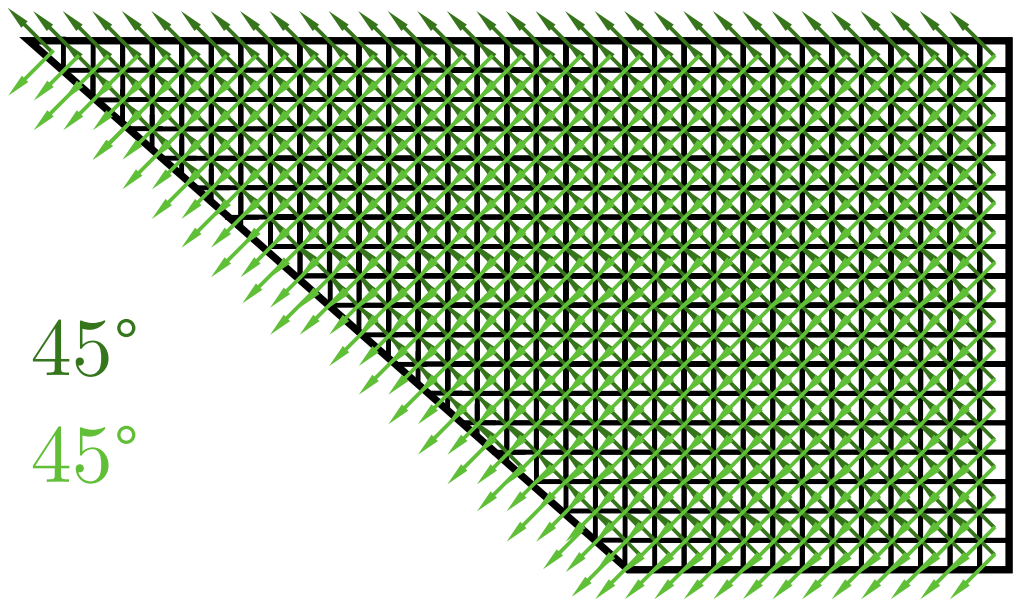
[picture p123: page 1]
