MDNich/MIT_Rkt_Aurora_Aero/FEA_docs/ACPpre.pdf

A

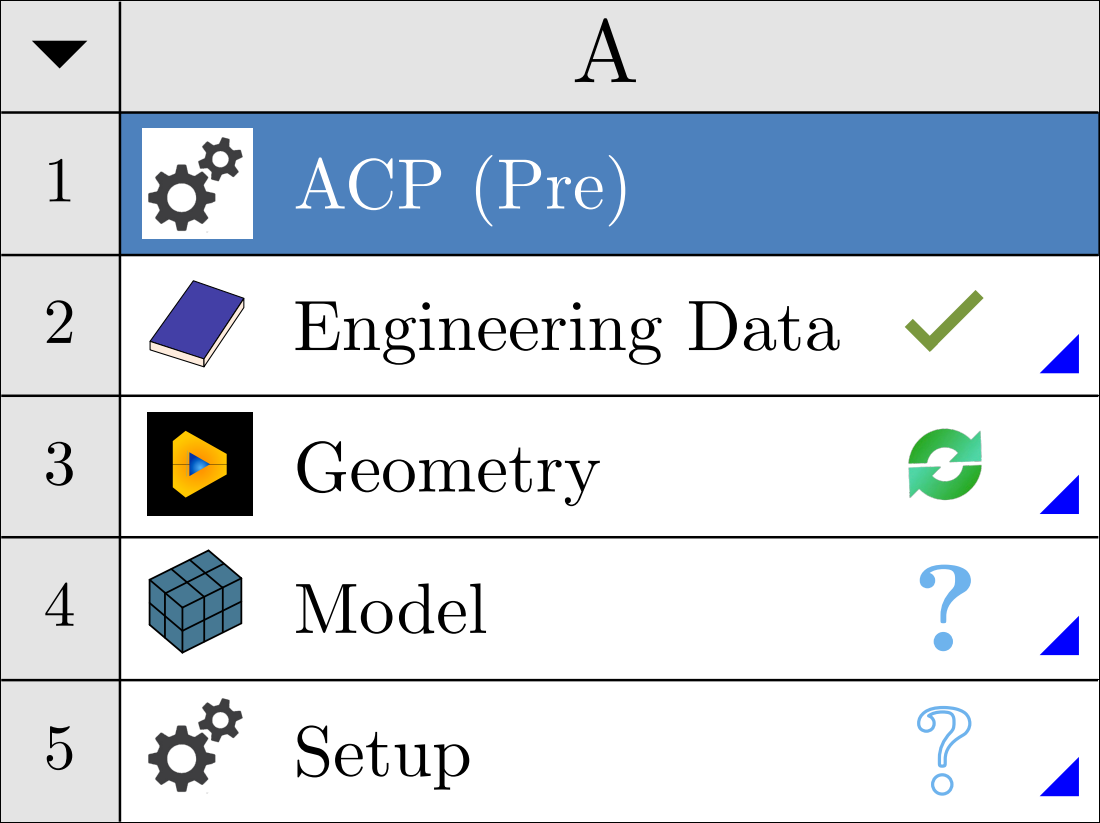
[picture p124: page 1]
ACP (Pre); Engineering Data; Geometry; Model; Setup
