MDNich/MIT_Rkt_Aurora_Aero/AeroShell_proj/Analysis/src/out/figure2_mesh_2D.pdf

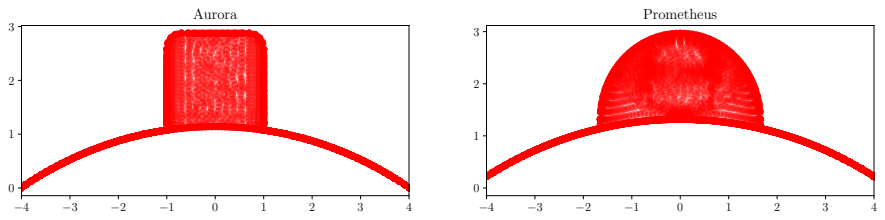
[picture p125: page 1]
Aurora; Prometheus
