MDNich/MIT_Rkt_Aurora_Aero/AeroShell_proj/Analysis/src/out/figure2_shear_3D.pdf

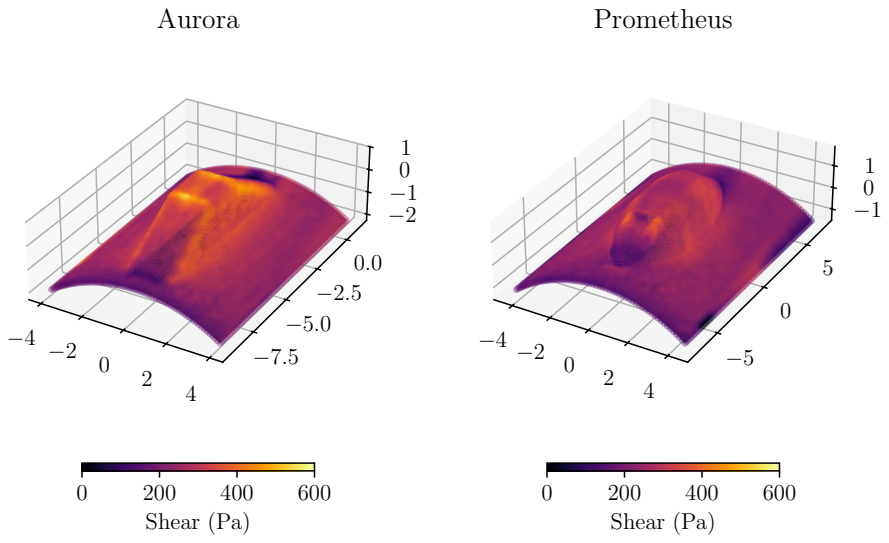
[picture p126: page 1]
Aurora; Shear (Pa); Prometheus
