MDNich/MIT_Rkt_Aurora_Aero/AeroShell_proj/Analysis/src/out/figure1.pdf

900

1000

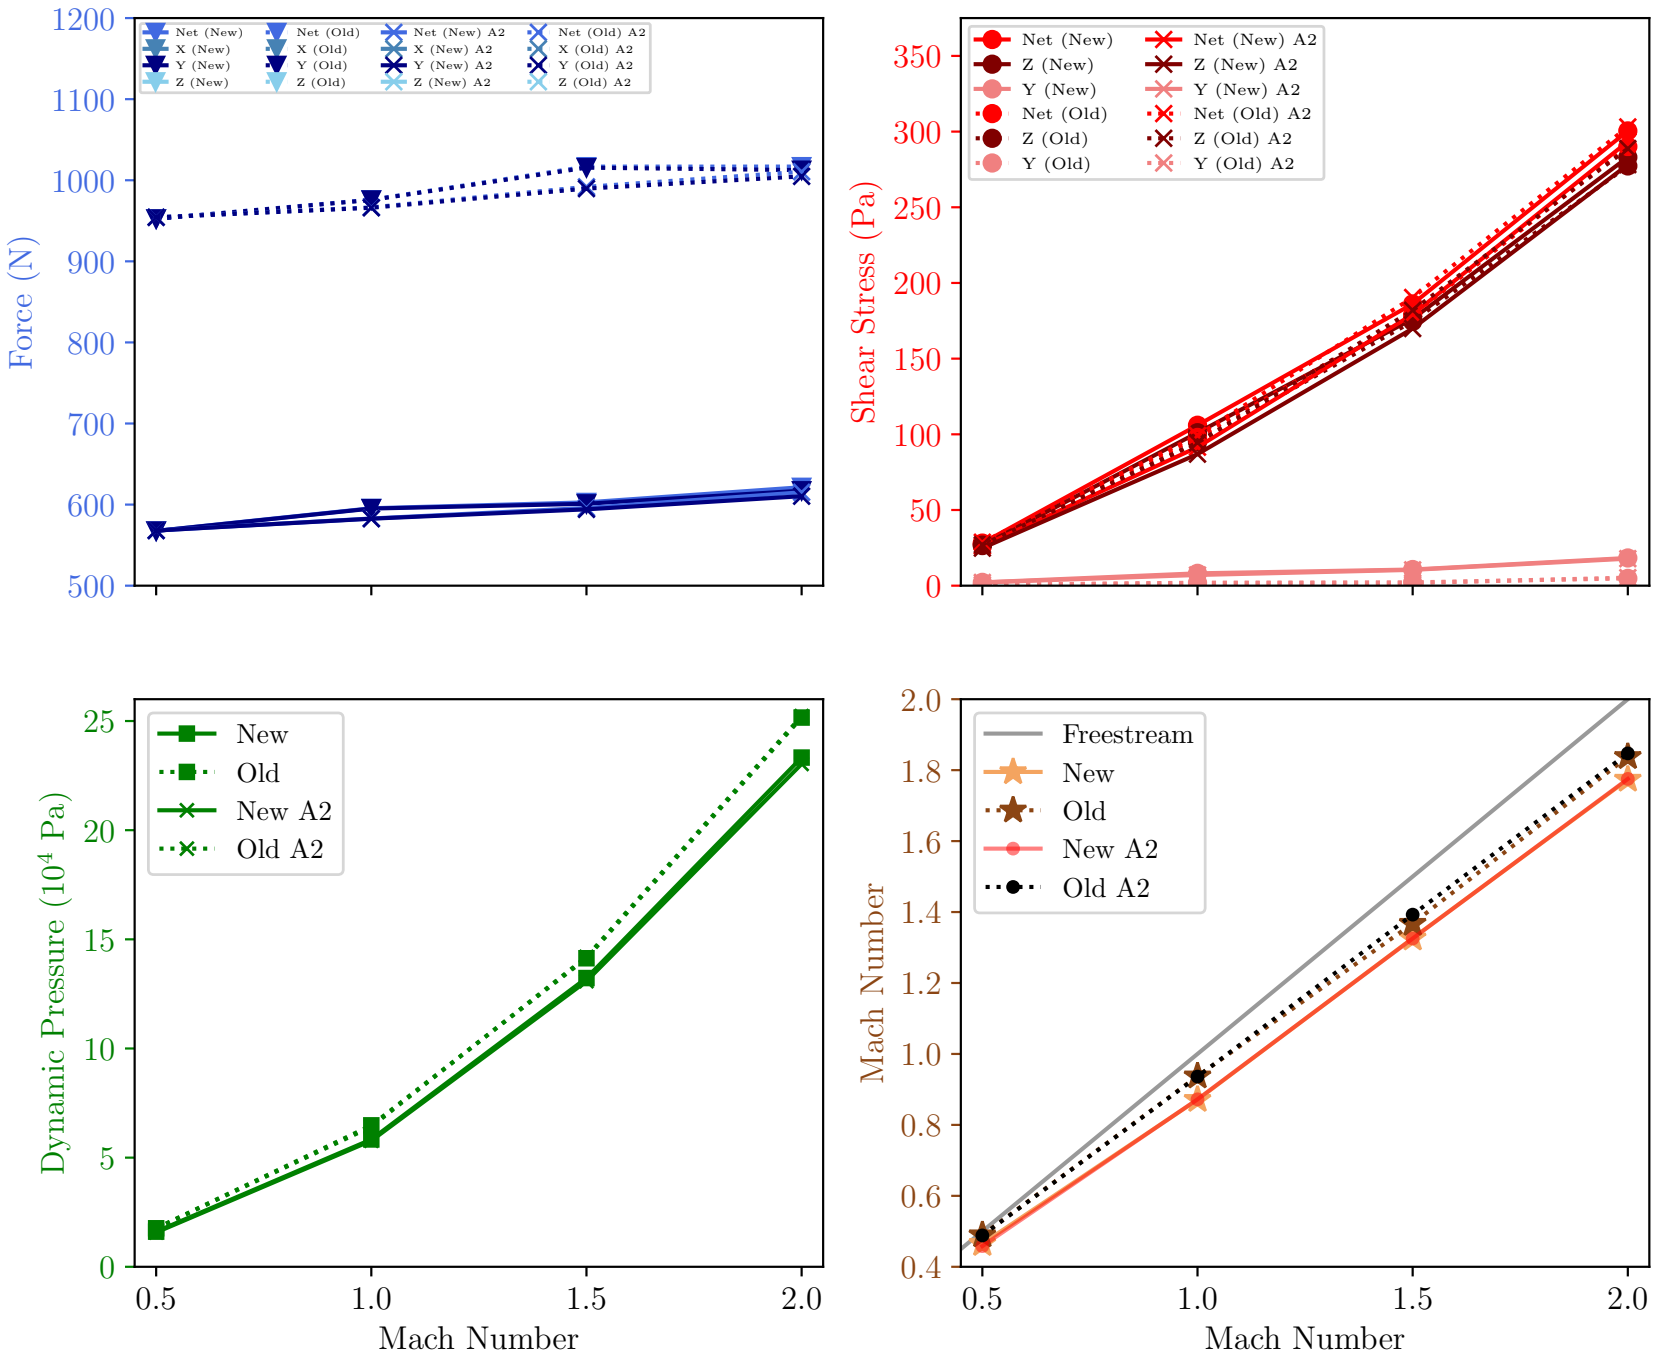
[picture p127: page 1]
Force (N); Net (New) X (New) Y (New) Z (New); Net (Old) X (Old) Y (Old) Z (Old); Net (New) A2 X (New) A2 Y (New) A2 Z (New) A2; Net (Old) A2 X (Old) A2 Y (Old) A2 Z (Old) A2; Net (New) Z (New) Y (New) Net (Old) Z (Old) Y (Old); Net (New) A2 Z (New) A2 Y (New) A2 Net (Old) A2 Z (Old) A2 Y (Old) A2; Mach Number; New Old New A2 Old A2; Freestream New Old New A2 Old A2

Shear Stress (Pa)

Dynamic Pressure (104 Pa)
