MDNich/MIT_Rkt_Aurora_Aero/AeroShell_proj/Analysis/src/out/figure2_mesh_3D.pdf

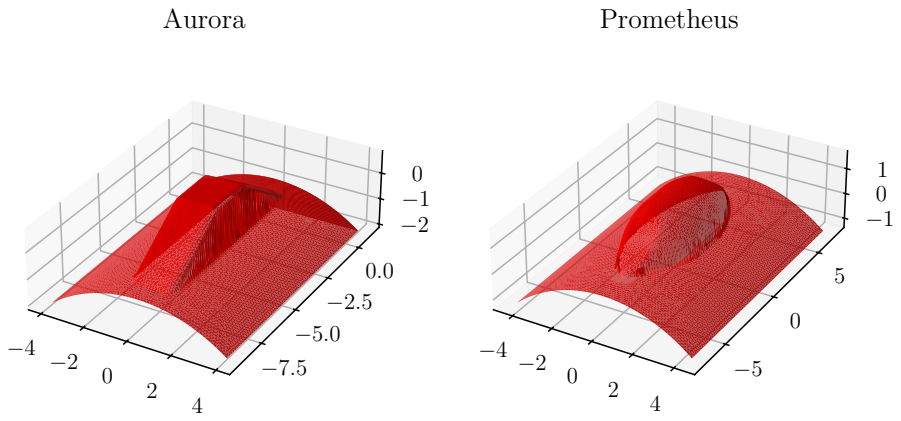
[picture p128: page 1]
Aurora; Prometheus
