MDNich/MIT_Rkt_Aurora_Aero/(commit log)

2024-10-05 Add results
    [Aeroshell1.0.SLDPRT, Aeroshell_Prometheus_Assem_FINAL_12Apr2024.SLDASM, Assembly1.0.SLDASM, Bstr_Aeroshell_Prometheus_1.1_HOLLOW_SHELL_29Jan2024.SLDPRT, Bstr_Aeroshell_Prometheus_1.1_SKELETON_29Jan2024.SLDPRT, Bstr_Aeroshell_Prometheus_1.3_SKELETON_12Apr2024.SLDPRT, GlassPanel.SLDPRT, Glass_Cover_Aeroshell_Medusa.SLDPRT]
2024-10-05 Add Mach1
    [Aeroshell_Prometheus_Assem_FINAL_12Apr2024.SLDASM]
2024-10-05 New Design Results
    [Assembly1.0.SLDASM, CylindreDummy.SLDPRT, global_parameters.txt]
2024-10-05 Mach 1 results from old
    [Aeroshell_Prometheus_Assem_FINAL_12Apr2024.SLDASM, Assembly1.0.SLDASM, global_parameters.txt]
2024-10-06 STEP, preview images.
    [Aeroshell_Prometheus_Assem_FINAL_12Apr2024.SLDASM, Assembly1.0.SLDASM]
2024-10-06 .5 and 1.5 mach old model data CFD
    [Aeroshell_Prometheus_Assem_FINAL_12Apr2024.SLDASM, global_parameters.txt]
2024-10-06 Add 1.5 0.5 Mach New
    [Assembly1.0.SLDASM, global_parameters.txt]
2024-10-09 slight modiv
    [Assembly1.0.SLDASM]
2024-10-12 push new simulation setup
    [Aeroshell_Prometheus_Assem_FINAL_12Apr2024.SLDASM]
2024-10-12 sim results
    [Aeroshell_Prometheus_Assem_FINAL_12Apr2024.SLDASM, global_parameters.txt]
2024-10-12 sim prep - new
    [Assembly1.0.SLDASM]
2024-10-12 sim results - new
    [10_Goal Plot 1.xlsx, 5_Goal Plot 1.xlsx, 6_Goal Plot 1.xlsx, 7_Goal Plot 1.xlsx, 8_Goal Plot 1.xlsx, 9_Goal Plot 1.xlsx, Assembly1.0.SLDASM, global_parameters.txt]
2024-10-12 xlsx tmp
    [Aeroshell_Prometheus_Assem_FINAL_12Apr2024.SLDASM, nM0p5A0.xlsx, nM1p0A0.xlsx, nM1p5A0.xlsx, nM2p0A0.xlsx, new_0p5.xlsx, new_1.xlsx, new_1p5.xlsx]
2024-10-12 CSV/xlsx + new plots
    [nM0p5A0.csv, nM0p5A2.csv, nM0p5A2.xlsx, nM0p5A5.csv, nM0p5A5.xlsx, nM1p0A0.csv, nM1p0A2.csv, nM1p0A2.xlsx]
2024-10-19 ansys attempts
    [Aeroshell1.0.SLDPRT, Aeroshell1.0_ANSYS.SLDPRT, Aeroshell1.0_ANSYS.STEP, Assembly1.0.SLDASM]
2024-10-19 ansys work
    [Aeroshell1.0_ANSYS.SLDPRT, Aeroshell1.0_ANSYS.STEP]
2024-10-20 fix step
    [Aeroshell1.0_ANSYS.SLDPRT, Aeroshell1.0_ANSYS.STEP]
2024-10-20 IT WORKS
    [Aeroshell1.0_ANSYS.SLDPRT, Aeroshell1.0_ANSYS_ONEBOX.STEP, Aeroshell1.0_ANSYS_THISWILLWORK.STEP, mesh.stl]
2024-10-26 add new sims + fin can
    [AirFrame.SLDPRT, Assemblage1.SLDASM, AssemblageEnPartie.SLDPRT, coquille.SLDPRT, coquille_jouer.SLDPRT, fin.SLDPRT, finCanAssem.SLDPRT]
2024-11-02 fixed silly geese
    [finCan_new.SLDPRT, finCan_new.STEP]
2024-11-23 new fin dims
    [CureChamberAssem.SLDASM, bulb.SLDPRT, chamber.SLDPRT, finCan_justfin.SLDPRT, finCan_justfin.STEP, finCan_new_2024.11.10.13h29.SLDPRT, finCan_new_2024.11.23.15h23.SLDPRT, finCan_new_2024.11.23.15h23.STEP]
2024-11-24 FEA complete.
    [bonding.SLDPRT, bonding.STEP]
2024-12-04 add stuffs
    [finCan_CoresAndEpoxyFillets.SLDPRT, finCan_CoresAndEpoxyFillets.STEP, finCan_epoxyFillets.SLDPRT, finCan_epoxyFillets.STEP, finCan_finCores.SLDPRT, finCan_finCores.STEP, finCan_finLayups.SLDPRT, finCan_finLayups.STEP]
2024-12-20 finCan Changes
    [finCanJigLargePiece3Dprint.3MF, finCanJigLargePiece3Dprint.SLDPRT, finCanJigSmallPiece3Dprint.3MF, finCanJigSmallPiece3Dprint.SLDPRT]
2025-01-17 adj dim 1.8
    [assemFus.SLDASM, aura-aerod-finCan-v1.7.SLDPRT, aura-aerod-finCan-v1.8.SLDPRT, aura-aerod-finCan-v1.8.STEP, finCan_new_2025.01.17.13h50.SLDPRT]
2025-01-24 finally updated assembly
    [Fillet7.SLDPRT, aura-aerod-finCan-v1.9.SLDPRT, finCanJigLargePiece3Dprint_mirrorVersion.SLDPRT, finCanJigSmallPiece3Dprint.SLDPRT, finCanOutsideJust_main.SLDPRT, jig_1.SLDPRT, jig_2.SLDPRT, jig_3.SLDPRT]
